jharvey/StingrayIII/cad/stingray3-top.jpg

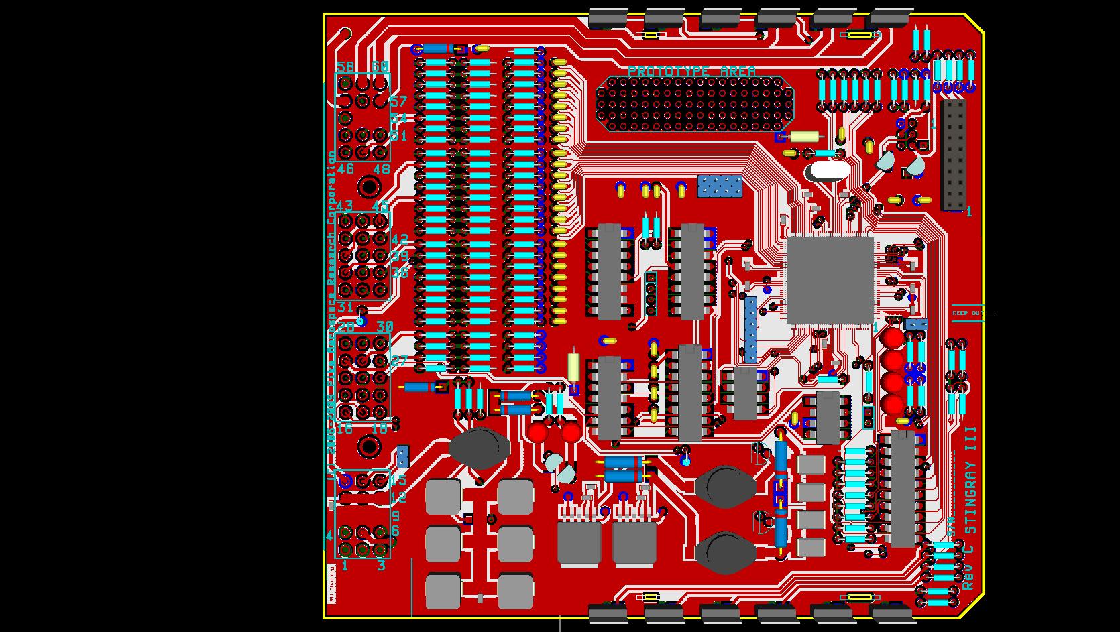
cad/stingray3-top.jpg
