jharvey/StingrayIII/cad/stingray3-3d.jpg

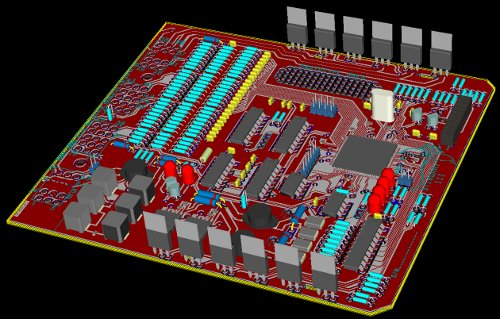
cad/stingray3-3d.jpg
