jharvey/StingrayIII/cad/PCB_trace-via_specs.xls

Key notes from the below (summary)
A min trace width of 10 mills, is good for 8/8 PCB houses and can handle .444 internal amps and .886 external amps
For 1 amp you and 1 oz copper, use a trace width wider than 11.8 mil external, and 30.8 mills internal. Min via drill of 20 mil.
For 5 amp you and 1 oz copper, use a trace width wider than 109 mil external, and 283 mills internal. Min via drill of 45 mil.
For 10 amp you and 1 oz copper, use a trace width wider than 283 mil external, and 737 mills internal. Min via drill of 123 mil.
Per online calculator found here http://circuitcalculator.com/wordpress/2006/01/31/pcb-trace-width-calculator
min via's from http://batchpcb.com/index.php/Faq via calcs from http://circuitcalculator.com/wordpress/2006/03/12/pcb-via-calculator/
9 mill wide trace (KICAD help file class 4 IPC class?) |  |  |  | 13 mil min drill diameter
current .8201 A |  | current .4101 A |  | 15 | mil finished hole dia
1 oz/ft^2 |  | 1 oz/ft^2 |  | 1 | mil plating thickness
temp rise 10 c |  | temp rise 10 c |  | 60 | mil via length
ambient 25 c |  | ambient 25 c
1 inch long |  | 1 inch long |  | 4 | amps applied
 |  |  |  | 1.9e-06 | Ohm-cm plating resistivity
--- for and external trace--- |  | --- for an internal trace---
internal trace |  | internal trace |  | 0.000893 | Ohms
23.4 | mill | 9 | mill | 0.0357 | Volts dropped
0.0216 | ohm | 0.0561 | ohm | 0.0143 | Watts dissipated
0.0177 | V drop | 0.0230 | V drop | 2.26 | Amps estimated ampacity
0.0145 | Watts | 0.0094 | Watts
external trace |  | external trace
9 | mill | 3.46 | mill
0.0561 | ohm | 0.146 | ohm
0.0460 | V drop | 0.060 | V drop
0.0377 | Watts | 0.025 | Watts
10 mill wide trace (min recommended for an 8/8 PCB house) |  |  |  | 20 mil min drill diameter
current .886 A |  | current .444 A |  | 22 | mil finished hole dia
1 oz/ft^2 |  | 1 oz/ft^2 |  | 1 | mil plating thickness
temp rise 10 c |  | temp rise 10 c |  | 60 | mil via length
ambient 25 c |  | ambient 25 c
1 inch long |  | 1 inch long |  | 2.94 | amps applied
 |  |  |  | 1.9e-06 | Ohm-cm plating resistivity
--- for and external trace--- |  | --- for an internal trace---
internal trace |  | internal trace |  | 0.000621 | Ohms
26 | mill | 10 | mill | 0.00183 | Volts dropped
0.0194 | ohm | 0.0503 | ohm | 0.00537 | Watts dissipated
0.0172 | V drop | 0.0223 | V drop | 2.94 | Amps estimated ampacity
0.0152 | Watts | 0.0099 | Watts
external trace |  | external trace
10 | mill | 3.86 | mill
0.0504 | ohm | 0.131 | ohm
0.0447 | V drop | 0.058 | V drop
0.0396 | Watts | 0.026 | Watts
Trace width |  |  | via calcs
current 1 A |  |  | 15 | mil finished hole dia
1 oz/ft^2 |  |  | 1 | mil plating thickness
temp rise 10 c |  |  | 60 | mil via length
ambient 25 c |  |  | 13 | drill dia
1 inch long |  |  | 1 | amps applied
 |  |  | 1.9e-06 | Ohm-cm plating resistivity
internal trace
30.8 | mill |  | 0.000893 | Ohms
0.0164 | ohm |  | 0.0357 | Volts dropped
0.0164 | V drop |  | 0.0143 | Watts dissipated
0.0164 | Watts |  | 2.26 | Amps estimated ampacity
external trace
11.8 | mill
0.0427 | ohm
0.0427 | V drop
0.0427 | Watts
Trace width |  |  | via calcs
current 5 A |  |  | 47 | mil finished hole dia
1 oz/ft^2 |  |  | 1 | mil plating thickness
temp rise 10 c |  |  | 60 | mil via length
ambient 25 c |  |  | 45 | drill dia
1 inch long |  |  | 1 | amps applied
 |  |  | 1.9e-06 | Ohm-cm plating resistivity
internal trace
283 | mill |  | 0.000298 | Ohms
0.0018 | ohm |  | 0.00149 | Volts dropped
0.0089 | V drop |  | 0.00744 | Watts dissipated
0.0445 | Watts |  | 5.02 | Amps estimated ampacity
external trace
109 | mill
0.0046 | ohm
0.0232 | V drop
0.1160 | Watts
Trace width |  |  | via calcs
current 10 A |  |  | 125 | mil finished hole dia
1 oz/ft^2 |  |  | 1 | mil plating thickness
temp rise 10 c |  |  | 60 | mil via length
ambient 25 c |  |  | 123 | drill dia
1 inch long |  |  | 10 | amps applied
 |  |  | 1.9e-06 | Ohm-cm plating resistivity
internal trace
737 | mill |  | 0.000113 | Ohms
0.0007 | ohm |  | 0.00113 | Volts dropped
0.0069 | V drop |  | 0.0113 | Watts dissipated
0.0685 | Watts |  | 10.1 | Amps estimated ampacity
external trace
283 | mill
0.0018 | ohm
0.0178 | V drop
0.1780 | Watts
