jharvey/StingrayIII/cad/scripts/stingray-417x500.jpg

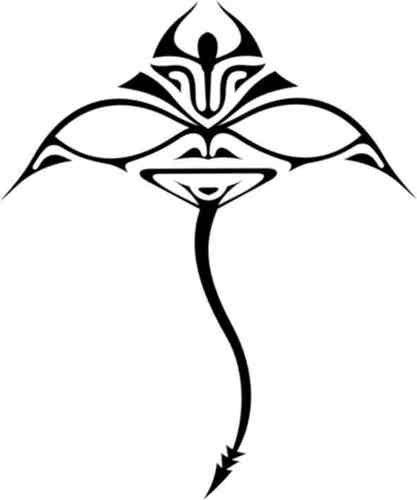
cad/scripts/stingray-417x500.jpg
