jharvey/StingrayIII/cad/stingray3.xlsx

REFERENCE | VALUE | FOOTPRINT | ADDITIONAL | MANUFACTURER | MANUFACTURER PART# | DIGIKEY PART# | DIGIKEY $ | NEWARKINONE PART # | NEWARKINONE $ | BEST PRICE
C101 | 100 nf | SM0805 | CAP CER .1UF 100V X7R 0805 | Murata Electronics | GCM21BR72A104KA37L | 490-4789-1-ND | 0.17
C102 | 100 nF | SM0805 | CAP CER .1UF 100V X7R 0805 | Murata Electronics | GCM21BR72A104KA37L | 490-4789-1-ND | 0.17
C103 | 100 nF | SM0805 | CAP CER .1UF 100V X7R 0805 | Murata Electronics | GCM21BR72A104KA37L | 490-4789-1-ND | 0.17
C104 | 100 nF | SM0805 | CAP CER .1UF 100V X7R 0805 | Murata Electronics | GCM21BR72A104KA37L | 490-4789-1-ND | 0.17
C105 | 100 nF | SM0805 | CAP CER .1UF 100V X7R 0805 | Murata Electronics | GCM21BR72A104KA37L | 490-4789-1-ND | 0.17
C106 | 100 nF | SM0805 | CAP CER .1UF 100V X7R 0805 | Murata Electronics | GCM21BR72A104KA37L | 490-4789-1-ND | 0.17
C107 | 100 nF | SM0805 | CAP CER .1UF 100V X7R 0805 | Murata Electronics | GCM21BR72A104KA37L | 490-4789-1-ND | 0.17
C108 | 100 nF | SM0805 | CAP CER .1UF 100V X7R 0805 | Murata Electronics | GCM21BR72A104KA37L | 490-4789-1-ND | 0.17
C109 | 100 nF | SM0805 | CAP CER .1UF 100V X7R 0805 | Murata Electronics | GCM21BR72A104KA37L | 490-4789-1-ND | 0.17
C110 | 22 pF | C1 | CAP 22PF 50V CERAMIC C0G 5% | Vishay | K220J15C0GF5TL2 | BC1005CT-ND | 0.076
C111 | 22 pF | C1 | CAP 22PF 50V CERAMIC C0G 5% | Vishay | K220J15C0GF5TL2 | BC1005CT-ND | 0.076
C112 | 100 nF | C1 | CAP .10UF 50V CERAMIC X7R 10% | Vishay | K104K15X7RF5TL2 | BC1084CT-ND | 0.081
C116 | 100 nF | C1 | CAP .10UF 50V CERAMIC X7R 10% | Vishay | K104K15X7RF5TL2 | BC1084CT-ND | 0.081
C123 | 100 nF | C1 | CAP .10UF 50V CERAMIC X7R 10% | Vishay | K104K15X7RF5TL2 | BC1084CT-ND | 0.081
C124 | 100 nF | C1 | CAP .10UF 50V CERAMIC X7R 10% | Vishay | K104K15X7RF5TL2 | BC1084CT-ND | 0.081
C125 | 100 nF | SM0805 | CAP CER .1UF 100V X7R 0805 | Murata Electronics | GCM21BR72A104KA37L | 490-4789-1-ND | 0.17
C160 | 2.2nF | C1 | CAP 2.2NF 50VDC X7R 10% RDL 2.54 | Kemet | C320C222K5R5CA | C320C222K5R5CA-ND | 0.08
C330 | 100 nF | C1 | CAP .10UF 50V CERAMIC X7R 10% | Vishay | K104K15X7RF5TL2 | BC1084CT-ND | 0.081
C331 | 100 nF | C1 | CAP .10UF 50V CERAMIC X7R 10% | Vishay | K104K15X7RF5TL2 | BC1084CT-ND | 0.081
C332 | 100 nF | C1 | CAP .10UF 50V CERAMIC X7R 10% | Vishay | K104K15X7RF5TL2 | BC1084CT-ND | 0.081
C333 | 100 nF | C1 | CAP .10UF 50V CERAMIC X7R 10% | Vishay | K104K15X7RF5TL2 | BC1084CT-ND | 0.081
C334 | 100 nF | C1 | CAP .10UF 50V CERAMIC X7R 10% | Vishay | K104K15X7RF5TL2 | BC1084CT-ND | 0.081
C335 | 100 nF | C1 | CAP .10UF 50V CERAMIC X7R 10% | Vishay | K104K15X7RF5TL2 | BC1084CT-ND | 0.081
C336 | 100 nF | C1 | CAP .10UF 50V CERAMIC X7R 10% | Vishay | K104K15X7RF5TL2 | BC1084CT-ND | 0.081
C337 | 100 nF | C1 | CAP .10UF 50V CERAMIC X7R 10% | Vishay | K104K15X7RF5TL2 | BC1084CT-ND | 0.081
C340 | 100 nF | C1 | CAP .10UF 50V CERAMIC X7R 10% | Vishay | K104K15X7RF5TL2 | BC1084CT-ND | 0.081
C341 | 100 nF | C1 | CAP .10UF 50V CERAMIC X7R 10% | Vishay | K104K15X7RF5TL2 | BC1084CT-ND | 0.081
C342 | 100 nF | C1 | CAP .10UF 50V CERAMIC X7R 10% | Vishay | K104K15X7RF5TL2 | BC1084CT-ND | 0.081
C343 | 100 nF | C1 | CAP .10UF 50V CERAMIC X7R 10% | Vishay | K104K15X7RF5TL2 | BC1084CT-ND | 0.081
C344 | 100 nF | C1 | CAP .10UF 50V CERAMIC X7R 10% | Vishay | K104K15X7RF5TL2 | BC1084CT-ND | 0.081
C345 | 100 nF | C1 | CAP .10UF 50V CERAMIC X7R 10% | Vishay | K104K15X7RF5TL2 | BC1084CT-ND | 0.081
C346 | 100 nF | C1 | CAP .10UF 50V CERAMIC X7R 10% | Vishay | K104K15X7RF5TL2 | BC1084CT-ND | 0.081
C347 | 100 nF | C1 | CAP .10UF 50V CERAMIC X7R 10% | Vishay | K104K15X7RF5TL2 | BC1084CT-ND | 0.081
C401 | 0.01uF | SM0805 | CAP CER 0.01UF 50V X7R RAD | Cornell Dubilier Electronics | M15R103K5-F | M15R103K5-F-ND | 0.1376
C402 | 100 nF | SM0805 | CAP CER .1UF 100V X7R 0805 | Murata Electronics | GCM21BR72A104KA37L | 490-4789-1-ND | 0.17
C403 | 47uF | SMD-CPOL-JA0
C404 | 47uF | SMD-CPOL-JA0
C405 | 47uF | SMD-CPOL-JA0
C406 | 100uF | SM2112L
C407 | 100uF | SM2112L
C411 | 0.01uF | SM0805 | CAP CER .1UF 100V X7R 0805 | Murata Electronics | GCM21BR72A104KA37L | 490-4789-1-ND | 0.17
C412 | 100 nF | SM0805 | CAP CER .1UF 100V X7R 0805 | Murata Electronics | GCM21BR72A104KA37L | 490-4789-1-ND | 0.17
C413 | 47uF | SMD-CPOL-JA0
C414 | 47uF | SMD-CPOL-JA0
C415 | 47uF | SMD-CPOL-JA0
C416 | 100uF | SM2112L
C417 | 100uF | SM2112L
C431 | 100 nF | C1 | CAP .10UF 50V CERAMIC X7R 10% | Vishay | K104K15X7RF5TL2 | BC1084CT-ND | 0.081
C441 | 100 nF | SM0805 | CAP CER .1UF 100V X7R 0805 | Murata Electronics | GCM21BR72A104KA37L | 490-4789-1-ND | 0.17
C442 | 100 nF | SM0805 | CAP CER .1UF 100V X7R 0805 | Murata Electronics | GCM21BR72A104KA37L | 490-4789-1-ND | 0.17
C701 | 100 nF | C1 | CAP .10UF 50V CERAMIC X7R 10% | Vishay | K104K15X7RF5TL2 | BC1084CT-ND | 0.081
C721 | 100 nF | C1 | CAP .10UF 50V CERAMIC X7R 10% | Vishay | K104K15X7RF5TL2 | BC1084CT-ND | 0.081
C722 | 100 nF | C1 | CAP .10UF 50V CERAMIC X7R 10% | Vishay | K104K15X7RF5TL2 | BC1084CT-ND | 0.081
C723 | 100 nF | C1 | CAP .10UF 50V CERAMIC X7R 10% | Vishay | K104K15X7RF5TL2 | BC1084CT-ND | 0.081
C724 | 100 nF | C1 | CAP .10UF 50V CERAMIC X7R 10% | Vishay | K104K15X7RF5TL2 | BC1084CT-ND | 0.081
C807 | 100 nF | C1 | CAP .10UF 50V CERAMIC X7R 10% | Vishay | K104K15X7RF5TL2 | BC1084CT-ND | 0.081
C1401 | 0.1uF | C1 | CAP .10UF 50V CERAMIC X7R 10% | Vishay | K104K15X7RF5TL2 | BC1084CT-ND | 0.081
C1402 | 0.1uF | C1 | CAP .10UF 50V CERAMIC X7R 10% | Vishay | K104K15X7RF5TL2 | BC1084CT-ND | 0.081
C1403 | 0.1uF | C1 | CAP .10UF 50V CERAMIC X7R 10% | Vishay | K104K15X7RF5TL2 | BC1084CT-ND | 0.081
C1404 | 0.1uF | C1 | CAP .10UF 50V CERAMIC X7R 10% | Vishay | K104K15X7RF5TL2 | BC1084CT-ND | 0.081
C1405 | 0.1uF | C1 | CAP .10UF 50V CERAMIC X7R 10% | Vishay | K104K15X7RF5TL2 | BC1084CT-ND | 0.081
C1406 | 0.1uF | C1 | CAP .10UF 50V CERAMIC X7R 10% | Vishay | K104K15X7RF5TL2 | BC1084CT-ND | 0.081
C1407 | 0.1uF | C1 | CAP .10UF 50V CERAMIC X7R 10% | Vishay | K104K15X7RF5TL2 | BC1084CT-ND | 0.081
C1408 | 0.1uF | C1 | CAP .10UF 50V CERAMIC X7R 10% | Vishay | K104K15X7RF5TL2 | BC1084CT-ND | 0.081
C1411 | 100 nF | C1 | CAP .10UF 50V CERAMIC X7R 10% | Vishay | K104K15X7RF5TL2 | BC1084CT-ND | 0.081
C1413 | 100 nF | C1 | CAP .10UF 50V CERAMIC X7R 10% | Vishay | K104K15X7RF5TL2 | BC1084CT-ND | 0.081
C1415 | 4.7uF | CP4
C1416 | 4.7uF | CP4
C1417 | 100 nF | C1 | CAP .10UF 50V CERAMIC X7R 10% | Vishay | K104K15X7RF5TL2 | BC1084CT-ND | 0.081
D104 | ST1 | LEDV | LED 5MM HI-EFF RED TRANS | Lite-On Inc. | LTL-307EE | 160-1701-ND | 0.09
D105 | ST2 | LEDV | LED 5MM HI-EFF RED TRANS | Lite-On Inc. | LTL-307EE | 160-1701-ND | 0.09
D106 | ST3 | LEDV | LED 5MM HI-EFF RED TRANS | Lite-On Inc. | LTL-307EE | 160-1701-ND | 0.09
D107 | ST4 | LEDV | LED 5MM HI-EFF RED TRANS | Lite-On Inc. | LTL-307EE | 160-1701-ND | 0.09
D156 | 1N4148 | D4 | DIODE SGL JUNC 100V 4.0NS DO-35 | Fairchild Semiconductor | 1N4148 | 1N4148FS-ND | 0.04
D157 | 1N4148 | D4 | DIODE SGL JUNC 100V 4.0NS DO-35 | Fairchild Semiconductor | 1N4148 | 1N4148FS-ND | 0.04
D166 | LED | LEDV | LED 5MM HI-EFF RED TRANS | Lite-On Inc. | LTL-307EE | 160-1701-ND | 0.09
D167 | LED | LEDV | LED 5MM HI-EFF RED TRANS | Lite-On Inc. | LTL-307EE | 160-1701-ND | 0.09
D401 | SB350 | D5 | DIODE SCHOTTKY 3A 50V DO-41 | Fairchild Semiconductor | SB350 | SB350-ND | 0.126
D402 | 1N5400 | D5 | RECTIFIER GPP 50V 3A DO-201AD | Diodes Inc. | 1N5400-T | 1N5400DICT-ND | 0.46
D411 | SB350 | D5 | DIODE SCHOTTKY 3A 50V DO-41 | Fairchild Semiconductor | SB350 | SB350-ND | 0.126
D412 | 1N5400 | D5 | RECTIFIER GPP 50V 3A DO-201AD | Diodes Inc. | 1N5400-T | 1N5400DICT-ND | 0.46
D431 | 4.7V | D4 | DIODE ZENER 1W 4.7V DO41 | Micro Commercial Co. | 1N4732A-TP | 1N4732A-TPCT-ND | 0.44
D826 | 1N4001 | D4 | DIODE GEN PURPOSE 50V 1A DO41 | Fairchild Semiconductor | 1N4001 | 1N4001FSCT-ND | 0.09
F101 | 4MHz | AWCR | RESONATOR 4.00MHZ CERAMIC INDUST | Murata Electronics | CSTLS4M00G53Z-B0 | 490-1221-ND | 0.29
J1 | 581-01-60-005 | 581-01-60-005 | ModICE I/O Connectors 60 Pos Black | CINCH | 581-01-60-005 | ----- |  | 78K5084 | 34.43
J101 | JTAG | pin_array_10x2
J431 | 12V24 | SIL-3
J701 | TERM | SIL-2
K2 | M0 | SIL-3
K4 | M1 | SIL-3
L401 | 22uH | PM5002 | INDUCTOR POWER 22UH 3.6A SMD | JW Miller | PM5022-220M-RC | M8599CT-ND | 1.35
L411 | 22uH | PM5002 | INDUCTOR POWER 22UH 3.6A SMD | JW Miller | PM5022-220M-RC | M8599CT-ND | 1.35
L441 | 22uH | PM5002 | INDUCTOR POWER 22UH 3.6A SMD | JW Miller | PM5022-220M-RC | M8599CT-ND | 1.35
P2 | AUX1 | SIL-4
P109 | CONN_1 | TEST_POINT
P110 | CONN_1 | TEST_POINT
P117 | R-T | SIL-3
P121 | CONN_1 | TEST_POINT
P122 | CONN_1 | TEST_POINT
P123 | CONN_1 | TEST_POINT
P124 | CONN_1 | TEST_POINT
P125 | CONN_1 | TEST_POINT
P126 | CONN_1 | TEST_POINT
P127 | CONN_1 | TEST_POINT
P128 | CONN_1 | TEST_POINT
P129 | CONN_1 | TEST_POINT
P130 | CONN_1 | TEST_POINT
P131 | CONN_1 | TEST_POINT
P132 | CONN_1 | TEST_POINT
P133 | CONN_1 | TEST_POINT
P134 | CONN_1 | TEST_POINT
P135 | CONN_1 | TEST_POINT
P136 | CONN_1 | TEST_POINT
Q101 | MPSA06 | TO92-INVERT | TRANSISTOR AMP NPN GP TO-92 | ON Semiconductor | MPSA06RLRAG | MPSA06RLRAGOSCT-ND | 0.42 | 45J1643 | 0.078
Q102 | MPSA06 | TO92-INVERT | TRANSISTOR AMP NPN GP TO-92 | ON Semiconductor | MPSA06RLRAG | MPSA06RLRAGOSCT-ND | 0.42 | 45J1643 | 0.078
Q103 | MPSA06 | TO92-INVERT | TRANSISTOR AMP NPN GP TO-92 | ON Semiconductor | MPSA06RLRAG | MPSA06RLRAGOSCT-ND | 0.42 | 45J1643 | 0.078
Q501 | IRGB14C40LPBF | TO220V_GCE | IGBT IGNITION 430V 20A TO220AB | International Rectifier | IRGB14C40LPBF | IRGB14C40LPBF-ND | 3.63 | 63J7438 | 3.56
Q502 | IRGB14C40LPBF | TO220V_GCE | IGBT IGNITION 430V 20A TO220AB | International Rectifier | IRGB14C40LPBF | IRGB14C40LPBF-ND | 3.63 | 63J7438 | 3.56
Q503 | IRGB14C40LPBF | TO220V_GCE | IGBT IGNITION 430V 20A TO220AB | International Rectifier | IRGB14C40LPBF | IRGB14C40LPBF-ND | 3.63 | 63J7438 | 3.56
Q504 | IRGB14C40LPBF | TO220V_GCE | IGBT IGNITION 430V 20A TO220AB | International Rectifier | IRGB14C40LPBF | IRGB14C40LPBF-ND | 3.63 | 63J7438 | 3.56
Q505 | IRGB14C40LPBF | TO220V_GCE | IGBT IGNITION 430V 20A TO220AB | International Rectifier | IRGB14C40LPBF | IRGB14C40LPBF-ND | 3.63 | 63J7438 | 3.56
Q506 | IRGB14C40LPBF | TO220V_GCE | IGBT IGNITION 430V 20A TO220AB | International Rectifier | IRGB14C40LPBF | IRGB14C40LPBF-ND | 3.63 | 63J7438 | 3.56
Q507 | IRGB14C40LPBF | TO220V_GCE | IGBT IGNITION 430V 20A TO220AB | International Rectifier | IRGB14C40LPBF | IRGB14C40LPBF-ND | 3.63 | 63J7438 | 3.56
Q508 | IRGB14C40LPBF | TO220V_GCE | IGBT IGNITION 430V 20A TO220AB | International Rectifier | IRGB14C40LPBF | IRGB14C40LPBF-ND | 3.63 | 63J7438 | 3.56
Q509 | IRGB14C40LPBF | TO220V_GCE | IGBT IGNITION 430V 20A TO220AB | International Rectifier | IRGB14C40LPBF | IRGB14C40LPBF-ND | 3.63 | 63J7438 | 3.56
Q510 | IRGB14C40LPBF | TO220V_GCE | IGBT IGNITION 430V 20A TO220AB | International Rectifier | IRGB14C40LPBF | IRGB14C40LPBF-ND | 3.63 | 63J7438 | 3.56
Q511 | IRGB14C40LPBF | TO220V_GCE | IGBT IGNITION 430V 20A TO220AB | International Rectifier | IRGB14C40LPBF | IRGB14C40LPBF-ND | 3.63 | 63J7438 | 3.56
Q512 | IRGB14C40LPBF | TO220V_GCE | IGBT IGNITION 430V 20A TO220AB | International Rectifier | IRGB14C40LPBF | IRGB14C40LPBF-ND | 3.63 | 63J7438 | 3.56
R101 | 1M | R3 | RES 1.0M OHM 1/4W 5% CARBON FILM | Yageo | CFR-25JB-1M0 | 1.0MQBK-ND | 0.064
R103 | 2K2 | R3 | RES 2.2K OHM 1/4W 5% CARBON FILM | Yageo | CFR-25JB-2K2 | 2.2KQBK-ND | 0.064
R107 | 1K5 | R3 | RES 1.5K OHM 1/4W 5% CARBON FILM | Yageo | CFR-25JB-1K5 | 1.5KQBK-ND | 0.064
R108 | 1K5 | R3 | RES 1.5K OHM 1/4W 5% CARBON FILM | Yageo | CFR-25JB-1K5 | 1.5KQBK-ND | 0.064
R109 | 1K5 | R3 | RES 1.5K OHM 1/4W 5% CARBON FILM | Yageo | CFR-25JB-1K5 | 1.5KQBK-ND | 0.064
R110 | 1K5 | R3 | RES 1.5K OHM 1/4W 5% CARBON FILM | Yageo | CFR-25JB-1K5 | 1.5KQBK-ND | 0.064
R116 | 2K | R3 | RES 2.0K OHM 1/4W 5% CARBON FILM | Yageo | CFR-25JB-2K0 | 2.0KQBK-ND | 0.064
R117 | 2K | R3 | RES 2.0K OHM 1/4W 5% CARBON FILM | Yageo | CFR-25JB-2K0 | 2.0KQBK-ND | 0.064
R122 | 1M3 | SM0805 | RES 1.30M OHM 1/8W 1% 0805 SMD | Yageo | RC0805FR-071M3L | 311-1.30MCRCT-ND | 0.74
R126 | 10K | R3 | RES 10K OHM 1/4W 5% CARBON FILM | Yageo | CFR-25JB-10K | 10KQBK-ND | 0.064
R127 | NC | R3
R128 | 10K | R3 | RES 10K OHM 1/4W 5% CARBON FILM | Yageo | CFR-25JB-10K | 10KQBK-ND | 0.064
R156 | 10K | R3 | RES 10K OHM 1/4W 5% CARBON FILM | Yageo | CFR-25JB-10K | 10KQBK-ND | 0.064
R157 | 10K | R3 | RES 10K OHM 1/4W 5% CARBON FILM | Yageo | CFR-25JB-10K | 10KQBK-ND | 0.064
R160 | 47K | R3 | RES 47K OHM 1/4W 5% CARBON FILM | Yageo | CFR-25JB-47K | 47KQBK-ND | 0.06
R161 | 10K | R3 | RES 10K OHM 1/4W 5% CARBON FILM | Yageo | CFR-25JB-10K | 10KQBK-ND | 0.064
R211 | 1K | R3 | RES 1.0K OHM 1/4W 5% CARBON FILM | Yageo | CFR-25JB-1K0 | 1.0KQBK-ND | 0.06
R212 | 1K | R3 | RES 1.0K OHM 1/4W 5% CARBON FILM | Yageo | CFR-25JB-1K0 | 1.0KQBK-ND | 0.06
R213 | 1K | R3 | RES 1.0K OHM 1/4W 5% CARBON FILM | Yageo | CFR-25JB-1K0 | 1.0KQBK-ND | 0.06
R214 | 1K | R3 | RES 1.0K OHM 1/4W 5% CARBON FILM | Yageo | CFR-25JB-1K0 | 1.0KQBK-ND | 0.06
R222 | 10K | R3 | RES 10K OHM 1/4W 5% CARBON FILM | Yageo | CFR-25JB-10K | 10KQBK-ND | 0.064
R223 | 10K | R3 | RES 10K OHM 1/4W 5% CARBON FILM | Yageo | CFR-25JB-10K | 10KQBK-ND | 0.064
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
R1446 | 4K7 | R3 | RES 4.7K OHM 1/4W 5% CARBON FILM | Yageo | CFR-25JB-4K7 | 4.7KQBK-ND | 0.064
R1447 | 4K7 | R3 | RES 4.7K OHM 1/4W 5% CARBON FILM | Yageo | CFR-25JB-4K7 | 4.7KQBK-ND | 0.064
R1448 | 10K | R3 | RES 10K OHM 1/4W 5% CARBON FILM | Yageo | CFR-25JB-10K | 10KQBK-ND | 0.064
U101 | STR730FZ2T7 | TQFP144 | IC MCU ARM7 256K FLASH 144-TQFP | ST Microelectronics | STR730FZ2T7 | 497-5140-1-ND | 28.62 | 24M7942 | 26.21
U102 | NCV33064P | TO92 | IC SENSOR UNDERVOLTAGE TO92 | ON Semiconductor | NCV33064P-5RAG | NCV33064P-5RAGOSCT-ND | 2.7
U103 | MCP6S28 | 16DIP-ELL300 | IC PGA 8CH R-R I/O 16DIP | Microchip Technology | MCP6S28-I/P | MCP6S28-I/P-ND | 2.66 | 58M8930 | 3.95
U104 | MCP3208 | 16DIP-ELL300 | IC ADC 12BIT 2.7V 8CH SPI 16-DIP | Microchip Technology | MCP3208-CI/P | MCP3208-CI/P-ND | 4.18 | 58K1815 | 3.48
U302 | 74HC14 | 14DIP-ELL300 | IC HEX INV SCHMITT TRIG 14-DIP | Texas Instruments | CD74HC14E | 296-12786-5-ND | 0.64 | 67K0138 | 0.576
U401 | LM2676-5.0 | TO263 | IC REG SIMPLE SWITCHER TO-263-7 | National Semiconductor | LM2676S-5.0/NOPB | LM2676S-5.0-ND | 4.48 | 41K4153 | 4.26
U402 | NCV33064P | TO92 | IC SENSOR UNDERVOLTAGE TO92 | ON Semiconductor | NCV33064P-5RAG | NCV33064P-5RAGOSCT-ND | 2.7
U411 | LM2676-5.0 | TO263 | IC REG SIMPLE SWITCHER TO-263-7 | National Semiconductor | LM2676S-5.0/NOPB | LM2676S-5.0-ND | 4.48 | 41K4153 | 4.26
U412 | NCV33064P | TO92 | IC SENSOR UNDERVOLTAGE TO92 | ON Semiconductor | NCV33064P-5RAG | NCV33064P-5RAGOSCT-ND | 2.7
U720 | MCP2551 | 8DIP-ELL300 | IC TRANSCEIVER CAN HI-SPD 8-DIP | Microchip Technology | MCP2551-I/P | MCP2551-I/P-ND | 1.32 | 69K7603 | 1.26
U721 | MAX232 | 16DIP-ELL300 | IC DUAL EIA-232 DRVR/RCVR 16-DIP | Texas Instruments | MAX232IN | 296-6940-5-ND | 0.9 | 37K0568 | 0.399
U722 | 25LC1024 | 8DIP-ELL300 | IC SERIAL EEPROM 1M 2.5V 8DIP | Microchip Technology | 25LC1024-I/P | 25LC1024-I/P-ND | 4.4 | 89H3176 | 3.14
U723 | 74HCT244 | 20DIP-ELL300 | IC BUS BUFFER TRI-ST OCTAL 20DIP | ST Microelectronics | M74HCT244B1R | 497-1903-5-ND | 0.67 | 89K0834 | 0.657
VR401 | 10K @ 25C | R1 | THERMISTOR NTC 10K OHM 5% TOLER | GE Sensing | C100F103J | 235-1002-ND | 5.2 | 52F3331 | 6.04
VR402 | 10K @ 25C | R1 | THERMISTOR NTC 10K OHM 5% TOLER | GE Sensing | C100F103J | 235-1002-ND | 5.2 | 52F3331 | 6.04
TOTALS |  |  |  |  |  |  | 132.4476 |  | 137.656
