jharvey/StingrayIII/cad/stingray3.cir

* EESchema Netlist Version 1.0 (Spice format) creation date: 12/8/2006-03:14:18


C721  40 39 0.1uF
C722  41 42 0.1uF
C724  43 0 0.1uF
C723  38 44 0.1uF
U721  39 44 40 41 42 43 35 33 29 31 32 30 34 36 0 38 MAX3232
C711  0 38 0.1uF
C701  0 38 0.1uF
R711  49 50 120
R701  51 52 120
U711  47 0 38 45 50 49 SN65HVD232Q
U701  48 0 38 46 52 51 SN65HVD232Q
U421  53 0 38 LM3940
C442  58 0 0.1uF
C441  54 0 0.1uF
L441  54 58 22uH
C432  38 0 0.1uF
C431  0 53 0.1uF
U431  53 55 59 0 0 1 2 38 SN74LVC2T45DCTR
R412  53 59 10K
R402  53 55 10K
R411  38 3 10K
R401  38 4 10K
C413  58 0 47uF
C414  58 0 47uF
C403  58 0 47uF
C404  58 0 47uF
C406  63 0 100uF
C416  60 0 100uF
C422  38 0 33uF
C421  53 0 0.47uF
U402  4 63 0 MC34064P
U412  3 60 0 MC34064P
D402  63 53 1N5400
D412  60 53 1N5400
C417  60 0 100uF
L411  61 60 22uH
D411  0 61 B340LA-13
C411  56 61 0.01uF
C412  58 0 0.1uF
C415  58 0 47uF
U411  61 58 56 0 62 53 59 LM2676
C407  63 0 100uF
L401  64 63 22uH
D401  0 64 B340LA-13
C401  57 64 0.01uF
C402  58 0 0.1uF
C405  58 0 47uF
U401  64 58 57 0 65 53 55 LM2676
R270  76 74 RPDN
R271  77 74 RPDN
R272  78 74 RPDN
R273  75 74 RPDN
R274  79 74 RPDN
R275  80 74 RPDN
R276  81 74 RPDN
R277  82 74 RPDN
R254  38 79 RPUP
R255  38 80 RPUP
R257  38 82 RPUP
R256  38 81 RPUP
C344  74 79 0.1uF
C347  74 82 0.1uF
C346  74 81 0.1uF
C345  74 80 0.1uF
D247  74 82 3.3V
D246  74 81 3.3V
D245  74 80 3.3V
D244  74 79 3.3V
R264  69 79 RIN
R265  68 80 RIN
R267  66 82 RIN
R266  67 81 RIN
D243  83 75 3.3V
D242  74 78 3.3V
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
D501  0 12 33V/5W
D507  0 6 33V/5W
D508  0 5 33V/5W
J1  13 14 12 11 10 9 54 0 0 316 315 314 313 312 311 298 297 296 295 294 293 292 291 290 289 288 287 286 285 283 284 282 281 280 279 278 277 276 275 310 309 308 307 306 305 304 303 302 301 300 299 0 0 54 5 6 7 8 15 16 581-01-60-005

.end
