jharvey/StingrayIII/cad/ad.sch

## KiCad design cad/ad.sch (2011-09-04)

Schematic: ad.sch

Parts:
C1301, C1302: 0.1uF
C1303, C1304: 4.7uF
U1301, U1302: TLV1548-Q1
