jharvey/StingrayIII/cad/amp.sch

## KiCad design cad/amp.sch (2011-09-04)

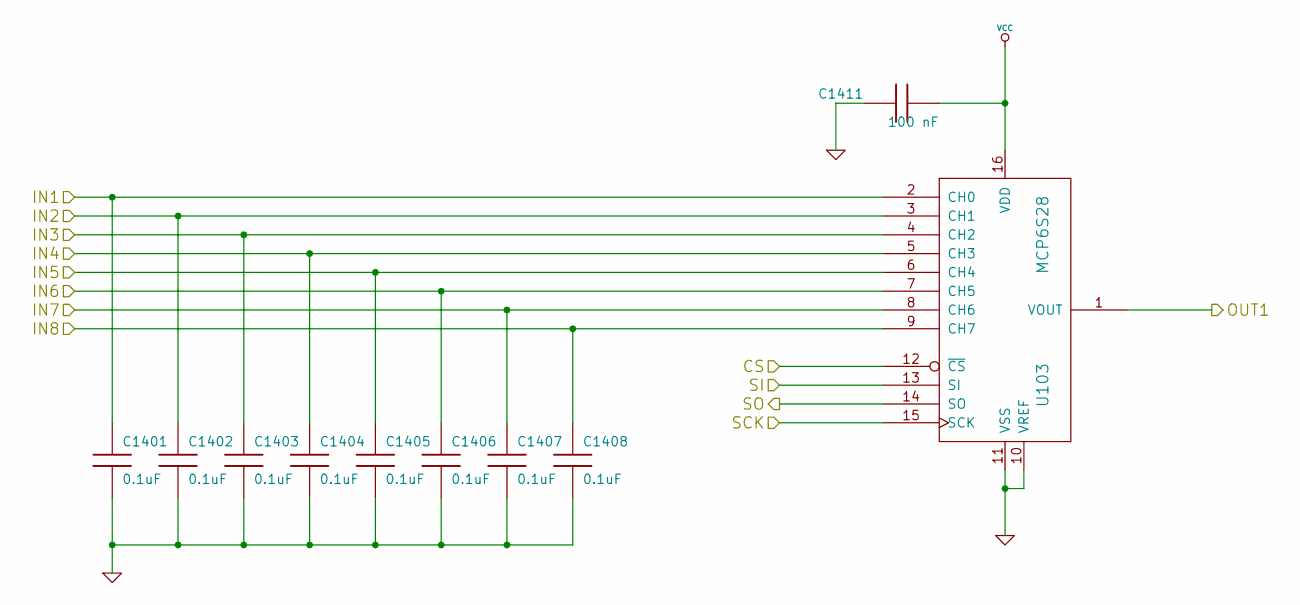
[picture p4: schematic amp.sch]

Parts:
C1401, C1402, C1403, C1404, C1405, C1406, C1407, C1408: 0.1uF
C1411: 100 nF
U103: MCP6S28

Connections:
CS: U103.12 (~CS)
GND: C1401.2, C1402.2, C1403.2, C1404.2, C1405.2, C1406.2, C1407.2, C1408.2, C1411.1, U103.10 (VREF), U103.11 (VSS)
IN1: C1401.1, U103.2 (CH0)
IN2: C1402.1, U103.3 (CH1)
IN3: C1403.1, U103.4 (CH2)
IN4: C1404.1, U103.5 (CH3)
IN5: C1405.1, U103.6 (CH4)
IN6: C1406.1, U103.7 (CH5)
IN7: C1407.1, U103.8 (CH6)
IN8: C1408.1, U103.9 (CH7)
OUT1: U103.1 (VOUT)
SCK: U103.15 (SCK)
SI: U103.13 (SI)
SO: U103.14 (SO)
VCC: C1411.2, U103.16 (VDD)
