jharvey/StingrayIII/cad/analog.sch

## KiCad design cad/analog.sch (2011-09-04)

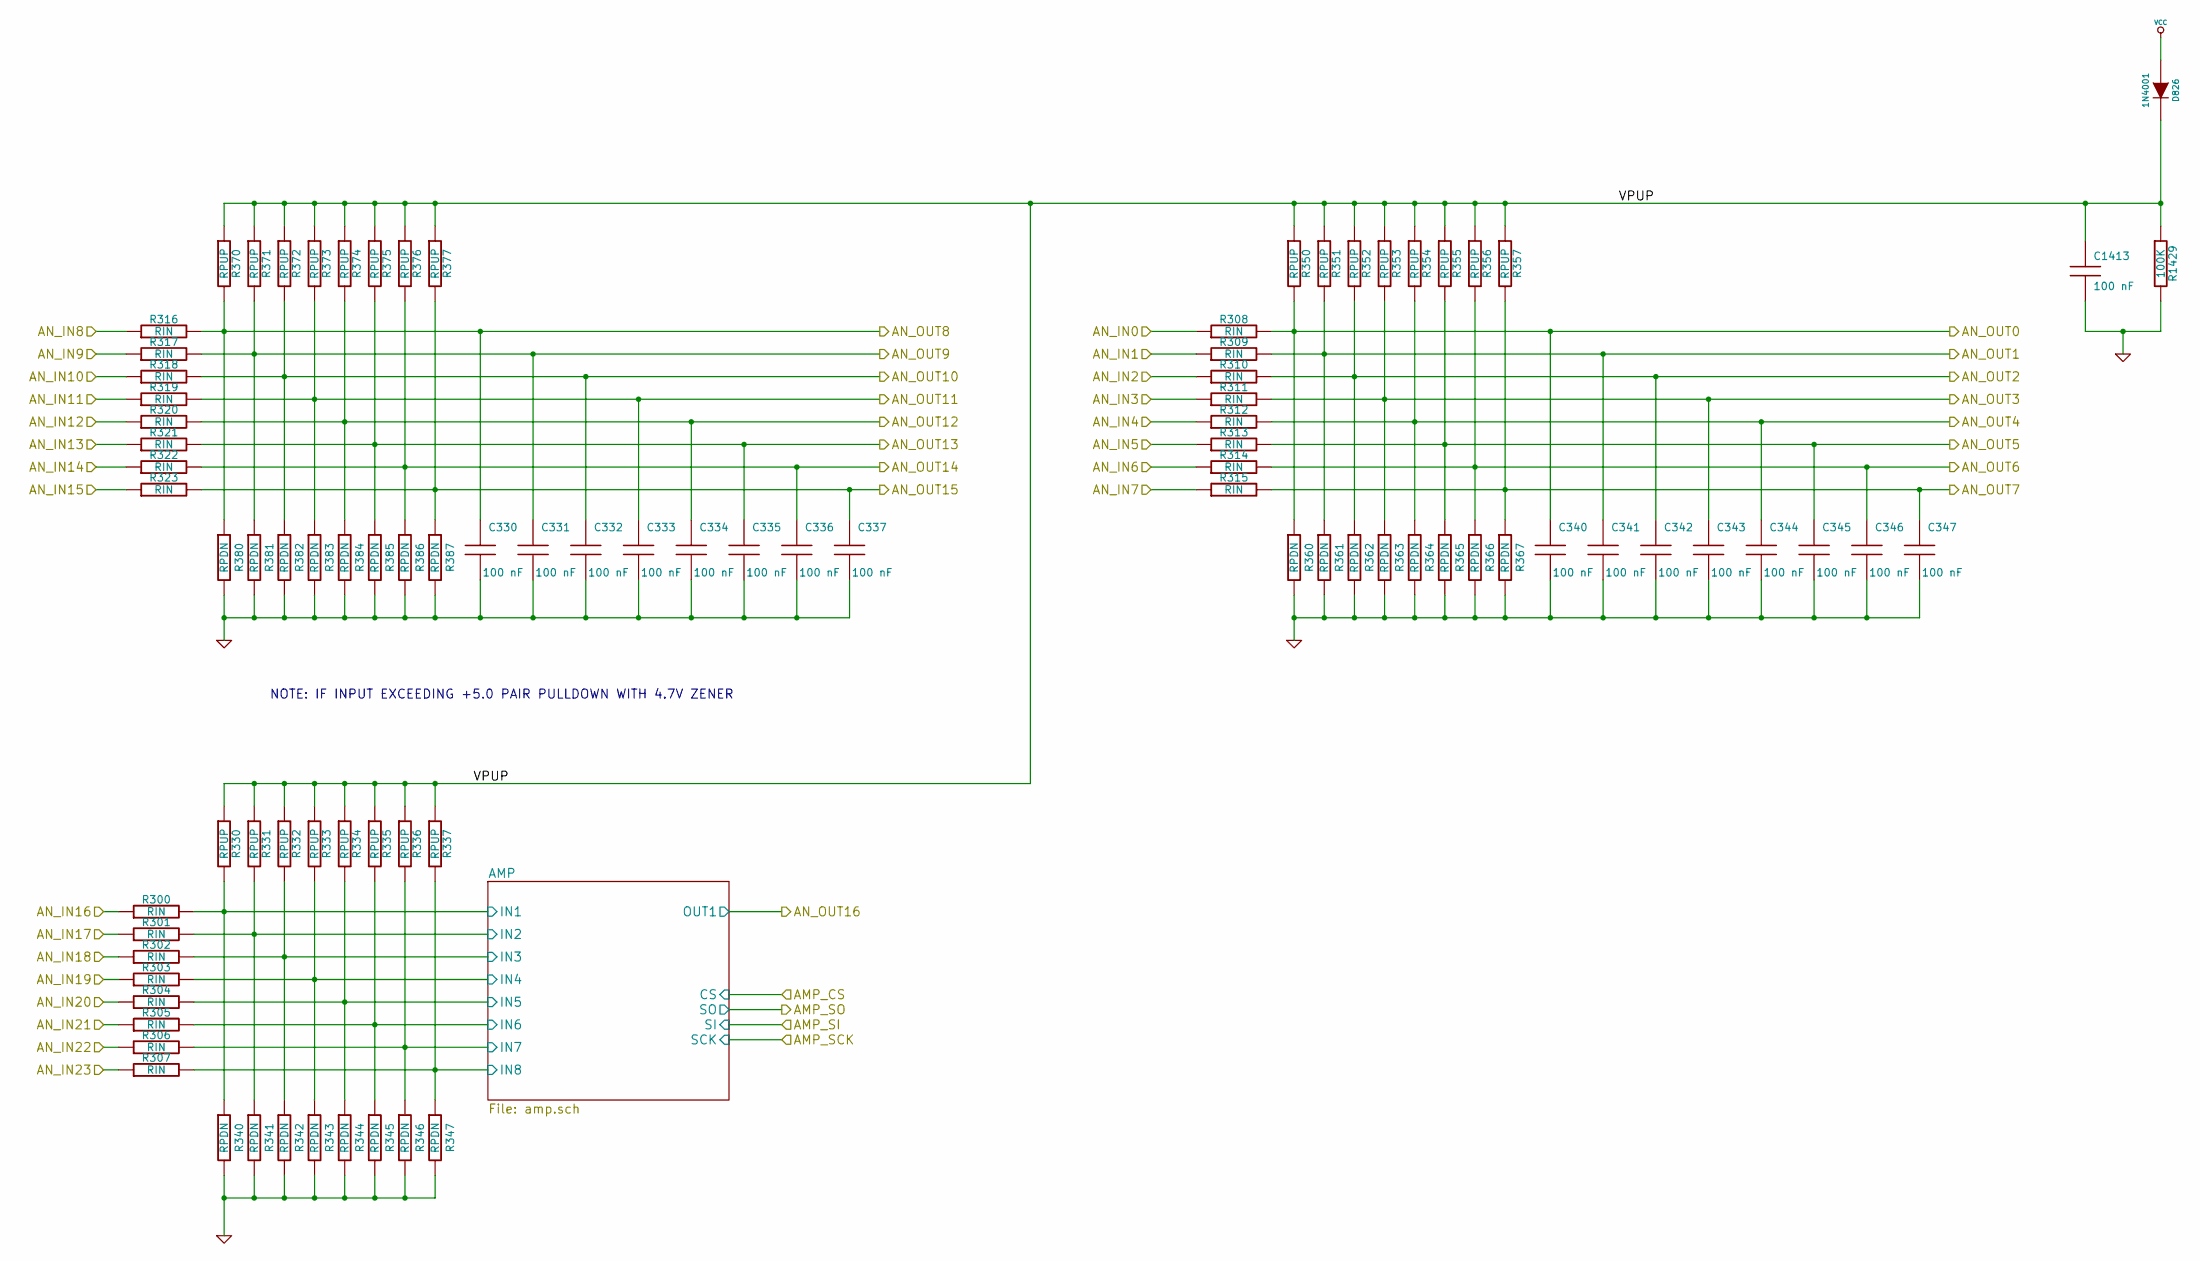
[picture p5: schematic analog.sch]

Parts:
C330, C331, C332, C333, C334, C335, C336, C337, C340, C341, C342, C343, C344, C345, C346, C347, C1413: 100 nF
D826: 1N4001
R300, R301, R302, R303, R304, R305, R306, R307, R308, R309, R310, R311, R312, R313, R314, R315, R316, R317, R318, R319, R320, R321, R322, R323: RIN
R330, R331, R332, R333, R334, R335, R336, R337, R350, R351, R352, R353, R354, R355, R356, R357, R370, R371, R372, R373, R374, R375, R376, R377: RPUP
R340, R341, R342, R343, R344, R345, R346, R347, R360, R361, R362, R363, R364, R365, R366, R367, R380, R381, R382, R383, R384, R385, R386, R387: RPDN
R1429: 100K

Connections:
AN_IN0: R308.1
AN_IN1: R309.1
AN_IN2: R310.1
AN_IN3: R311.1
AN_IN4: R312.1
AN_IN5: R313.1
AN_IN6: R314.1
AN_IN7: R315.1
AN_IN8: R316.1
AN_IN9: R317.1
AN_IN10: R318.1
AN_IN11: R319.1
AN_IN12: R320.1
AN_IN13: R321.1
AN_IN14: R322.1
AN_IN15: R323.1
AN_IN16: R300.1
AN_IN17: R301.1
AN_IN18: R302.1
AN_IN19: R303.1
AN_IN20: R304.1
AN_IN21: R305.1
AN_IN22: R306.1
AN_IN23: R307.1
AN_OUT0: C340.1, R308.2, R350.2, R360.1
AN_OUT1: C341.1, R309.2, R351.2, R361.1
AN_OUT2: C342.1, R310.2, R352.2, R362.1
AN_OUT3: C343.1, R311.2, R353.2, R363.1
AN_OUT4: C344.1, R312.2, R354.2, R364.1
AN_OUT5: C345.1, R313.2, R355.2, R365.1
AN_OUT6: C346.1, R314.2, R356.2, R366.1
AN_OUT7: C347.1, R315.2, R357.2, R367.1
AN_OUT8: C330.2, R316.2, R370.2, R380.1
AN_OUT9: C331.1, R317.2, R371.2, R381.1
AN_OUT10: C332.1, R318.2, R372.2, R382.1
AN_OUT11: C333.1, R319.2, R373.2, R383.1
AN_OUT12: C334.1, R320.2, R374.2, R384.1
AN_OUT13: C335.1, R321.2, R375.2, R385.1
AN_OUT14: C336.1, R322.2, R376.2, R386.1
AN_OUT15: C337.1, R323.2, R377.2, R387.1
GND: C330.1, C331.2, C332.2, C333.2, C334.2, C335.2, C336.2, C337.2, C340.2, C341.2, C342.2, C343.2, C344.2, C345.2, C346.2, C347.2, C1413.2, R340.2, R341.2, R342.2, R343.2, R344.2, R345.2, R346.2, R347.2, R360.2, R361.2, R362.2, R363.2, R364.2, R365.2, R366.2, R367.2, R380.2, R381.2, R382.2, R383.2, R384.2, R385.2, R386.2, R387.2, R1429.2
IN1: R300.2, R330.2, R340.1
IN2: R301.2, R331.2, R341.1
IN3: R302.2, R332.2, R342.1
IN4: R303.2, R333.2, R343.1
IN5: R304.2, R334.2, R344.1
IN6: R305.2, R335.2, R345.1
IN7: R306.2, R336.2, R346.1
IN8: R307.2, R337.2, R347.1
VCC: D826.1 (A)
VPUP: C1413.1, D826.2 (K), R330.1, R331.1, R332.1, R333.1, R334.1, R335.1, R336.1, R337.1, R350.1, R351.1, R352.1, R353.1, R354.1, R355.1, R356.1, R357.1, R370.1, R371.1, R372.1, R373.1, R374.1, R375.1, R376.1, R377.1, R1429.1

Notes on the sheet:
NOTE: IF INPUT EXCEEDING +5.0 PAIR PULLDOWN WITH 4.7V ZENER
