jharvey/StingrayIII/cad/clock2.sch

## KiCad design cad/clock2.sch (2011-09-04)

Schematic: clock2.sch

Parts:
C131, C132, C141, C142: 0.1uF
R152: 10K
U131, U132: MAX7381AXR106
U141: SN74LVC1G126
U142: SN74LVC1G125
U151: SN74LVC1G175
U152: 74LS166
U153: SN74LVC04G204
U154: SN74AHC1G32
