jharvey/StingrayIII/cad/clock.sch

## KiCad design cad/clock.sch (2011-09-04)

Schematic: clock.sch

Parts:
C131, C132, C141, C142, C151, C161, C181: 0.1uF
TP2: CONN_1
U131, U132: MAX7377
U141: SN74LVC1G126-EP
U142: SN74LVC1G125-EP
U151: SN74LVC1G80-EP
U161: TPS3824-33-Q1
U171: SN74LVC1G32-EP
U181: SN74LVC1G04-Q1

Notes on the sheet:
[0 - 1.8 V]
4 MHz
CLOCK MONITOR, AND DIAGNOSTICS
CLOCK GATE LOGIC
