jharvey/StingrayIII/cad/comm.sch

## KiCad design cad/comm.sch (2011-09-04)

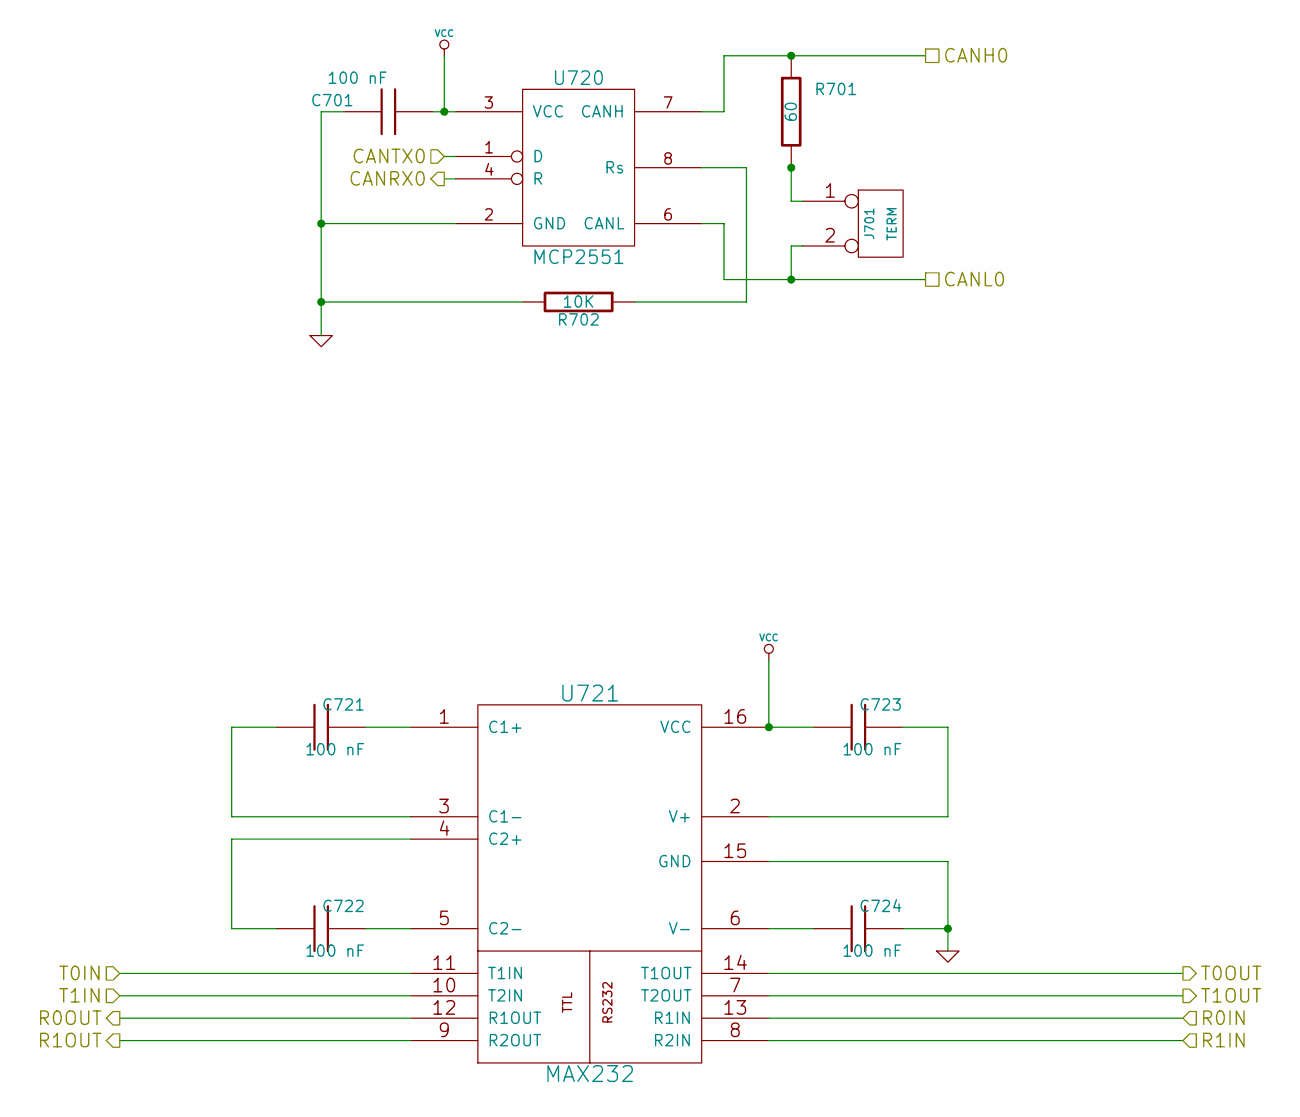
[picture p6: schematic comm.sch]

Parts:
C701, C721, C722, C723, C724: 100 nF
J701: TERM
R701: 60
R702: 10K
U720: MCP2551
U721: MAX232

Connections:
CANH0: R701.1, U720.7 (CANH)
CANL0: J701.2 (PM), U720.6 (CANL)
CANRX0: U720.4 (R)
CANTX0: U720.1 (D)
GND: C701.1, C724.2, R702.2, U720.2 (GND), U721.15 (GND)
unnamed: C721.1, U721.3 (C1-)
unnamed: C721.2, U721.1 (C1+)
unnamed: C722.1, U721.4 (C2+)
unnamed: C722.2, U721.5 (C2-)
unnamed: C723.2, U721.2 (V+)
unnamed: C724.1, U721.6 (V-)
unnamed: J701.1, R701.2
unnamed: R702.1, U720.8 (Rs)
R0IN: U721.13 (R1IN)
R0OUT: U721.12 (R1OUT)
R1IN: U721.8 (R2IN)
R1OUT: U721.9 (R2OUT)
T0IN: U721.11 (T1IN)
T0OUT: U721.14 (T1OUT)
T1IN: U721.10 (T2IN)
T1OUT: U721.7 (T2OUT)
VCC: C701.2, C723.1, U720.3 (VCC), U721.16 (VCC)
