jharvey/StingrayIII/cad/conn.sch

## KiCad design cad/conn.sch (2011-09-04)

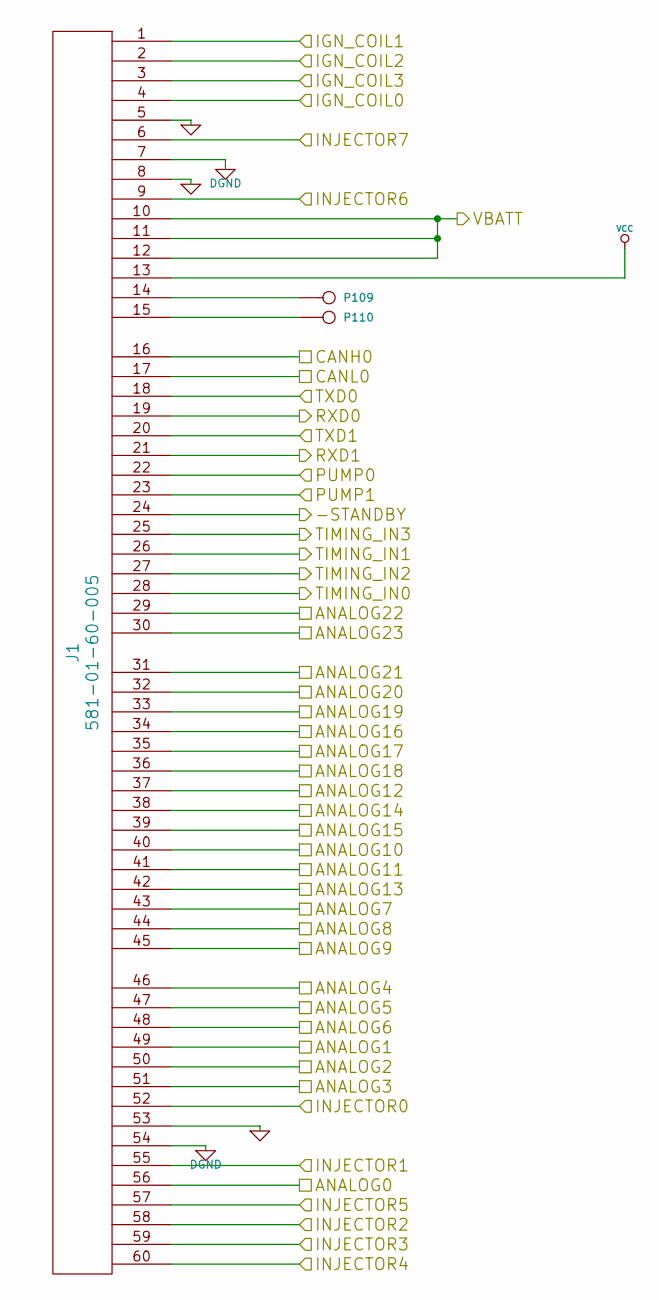
[picture p7: schematic conn.sch]

Parts:
J1: 581-01-60-005
P109, P110: CONN_1

Connections:
-STANDBY: J1.24
ANALOG0: J1.56
ANALOG1: J1.49
ANALOG2: J1.50
ANALOG3: J1.51
ANALOG4: J1.46
ANALOG5: J1.47
ANALOG6: J1.48
ANALOG7: J1.43
ANALOG8: J1.44
ANALOG9: J1.45
ANALOG10: J1.40
ANALOG11: J1.41
ANALOG12: J1.37
ANALOG13: J1.42
ANALOG14: J1.38
ANALOG15: J1.39
ANALOG16: J1.34
ANALOG17: J1.35
ANALOG18: J1.36
ANALOG19: J1.33
ANALOG20: J1.32
ANALOG21: J1.31
ANALOG22: J1.29
ANALOG23: J1.30
CANH0: J1.16
CANL0: J1.17
DGND: J1.7, J1.54
GND: J1.5, J1.8, J1.53
IGN_COIL0: J1.4
IGN_COIL1: J1.1
IGN_COIL2: J1.2
IGN_COIL3: J1.3
INJECTOR0: J1.52
INJECTOR1: J1.55
INJECTOR2: J1.58
INJECTOR3: J1.59
INJECTOR4: J1.60
INJECTOR5: J1.57
INJECTOR6: J1.9
INJECTOR7: J1.6
unnamed: J1.14, P109.1
unnamed: J1.15, P110.1
PUMP0: J1.22
PUMP1: J1.23
RXD0: J1.19
RXD1: J1.21
TIMING_IN0: J1.28
TIMING_IN1: J1.26
TIMING_IN2: J1.27
TIMING_IN3: J1.25
TXD0: J1.18
TXD1: J1.20
VBATT: J1.10, J1.11, J1.12
VCC: J1.13
