jharvey/StingrayIII/cad/dev470.sch

## KiCad design cad/dev470.sch (2011-09-04)

Schematic: dev470.sch

Parts:
C1: 0.01uF
C2, C3, C4, C5, C6, C7, C8, C9, C10, C11, C12, C13, C14, C15, C16, C17, C21, C22, C23, C24, C27: 0.1uF
C18: 0.22uF
C19: 2.2uF
C20, C28, C29, C30: 4.7uF
C25, C26: 18pF
D1: LED
J1: JTAG
J2: AWD
J3: DB9
P1, P2, P3, P4: CONN_36
P5: CAN
P6: CTRM
R1, R2: 10K
R3: 22K
R4: 4.7K
R5: 120
R6: 470
U1: TMS470R1B768
U2: M25P40
U3: MAX3232
U4: TPS79318
U5: SN65HVD232Q
X1: 16MHz

Notes on the sheet:
RTS
CTS
