jharvey/StingrayIII/cad/ign-drivers.sch

## KiCad design cad/ign-drivers.sch (2011-09-04)

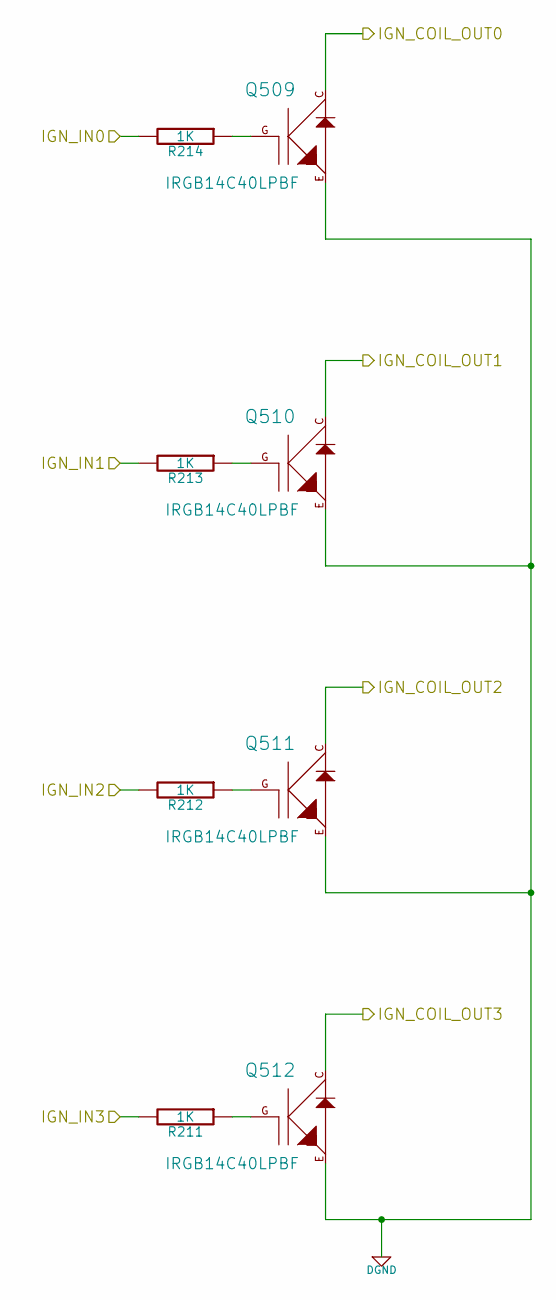
[picture p8: schematic ign-drivers.sch]

Parts:
Q509, Q510, Q511, Q512: IRGB14C40LPBF
R211, R212, R213, R214: 1K; R3_SM0805; tolerance 5%

Connections:
DGND: Q509.E, Q510.E, Q511.E, Q512.E
IGN_COIL_OUT0: Q509.C
IGN_COIL_OUT1: Q510.C
IGN_COIL_OUT2: Q511.C
IGN_COIL_OUT3: Q512.C
IGN_IN0: R214.2
IGN_IN1: R213.2
IGN_IN2: R212.2
IGN_IN3: R211.2
unnamed: Q509.G, R214.1
unnamed: Q510.G, R213.1
unnamed: Q511.G, R212.1
unnamed: Q512.G, R211.1
