jharvey/StingrayIII/cad/input.sch

## KiCad design cad/input.sch (2011-09-04)

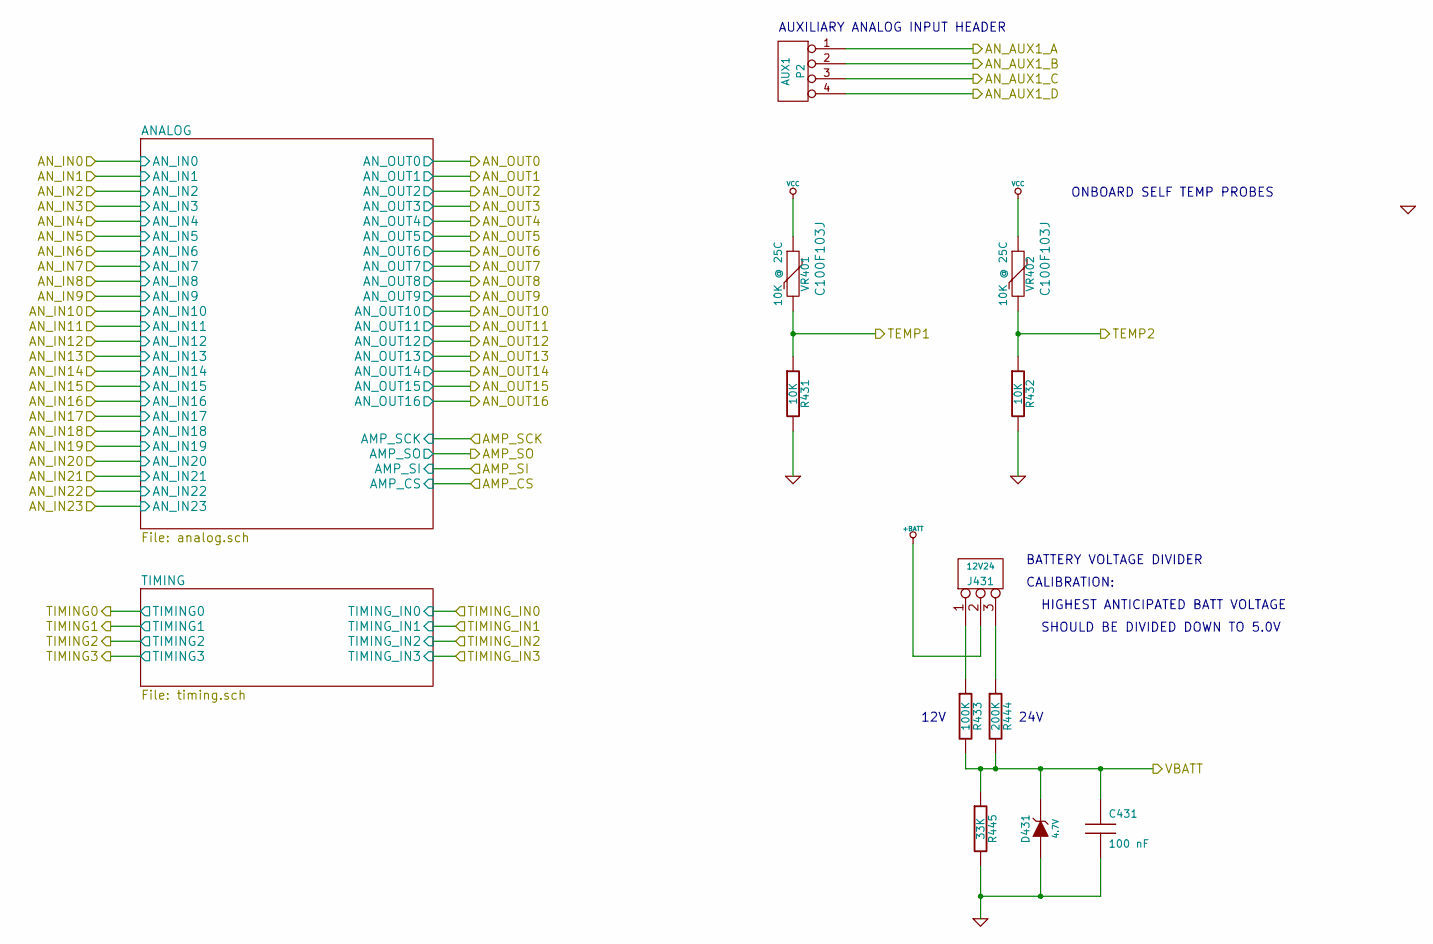
[picture p9: schematic input.sch]

Parts:
C431: 100 nF
D431: 4.7V
J431: 12V24
P2: AUX1
R431, R432: 10K
R433: 100K
R444: 200K
R445: 33K
VR401, VR402: 10K @ 25C

Connections:
+BATT: J431.2 (PM)
AN_AUX1_A: P2.1
AN_AUX1_B: P2.2
AN_AUX1_C: P2.3
AN_AUX1_D: P2.4
GND: C431.2, D431.1 (A), R431.2, R432.2, R445.2
unnamed: J431.1, R433.1
unnamed: J431.3, R444.1
TEMP1: R431.1, VR401.2
TEMP2: R432.1, VR402.2
VBATT: C431.1, D431.2 (K), R433.2, R444.2, R445.1
VCC: VR401.1, VR402.1

Notes on the sheet:
AUXILIARY ANALOG INPUT HEADER
SHOULD BE DIVIDED DOWN TO 5.0V
HIGHEST ANTICIPATED BATT VOLTAGE
CALIBRATION:
BATTERY VOLTAGE DIVIDER
ONBOARD SELF TEMP PROBES
24V
12V
