jharvey/StingrayIII/cad/knock.sch

## KiCad design cad/knock.sch (2011-09-04)

Schematic: knock.sch

Parts:
C852, C854: 100 nF
C853: 4.7uF
C855, C856: C
C1417, C1418: 22pF
R834: 10M
R835, R836, R837, R838: R
U725: TPIC8101
X2: 4MHz
