jharvey/StingrayIII/cad/lm7809.sch

## KiCad design cad/lm7809.sch (2011-09-04)

Schematic: lm7809.sch

Parts:
C1: .1uF
C2: 10 uF
P1, P2: CONN_1
U1: LM7809

Notes on the sheet:
+9V
BATT+
