jharvey/StingrayIII/cad/mcu.sch

## KiCad design cad/mcu.sch (2011-09-04)

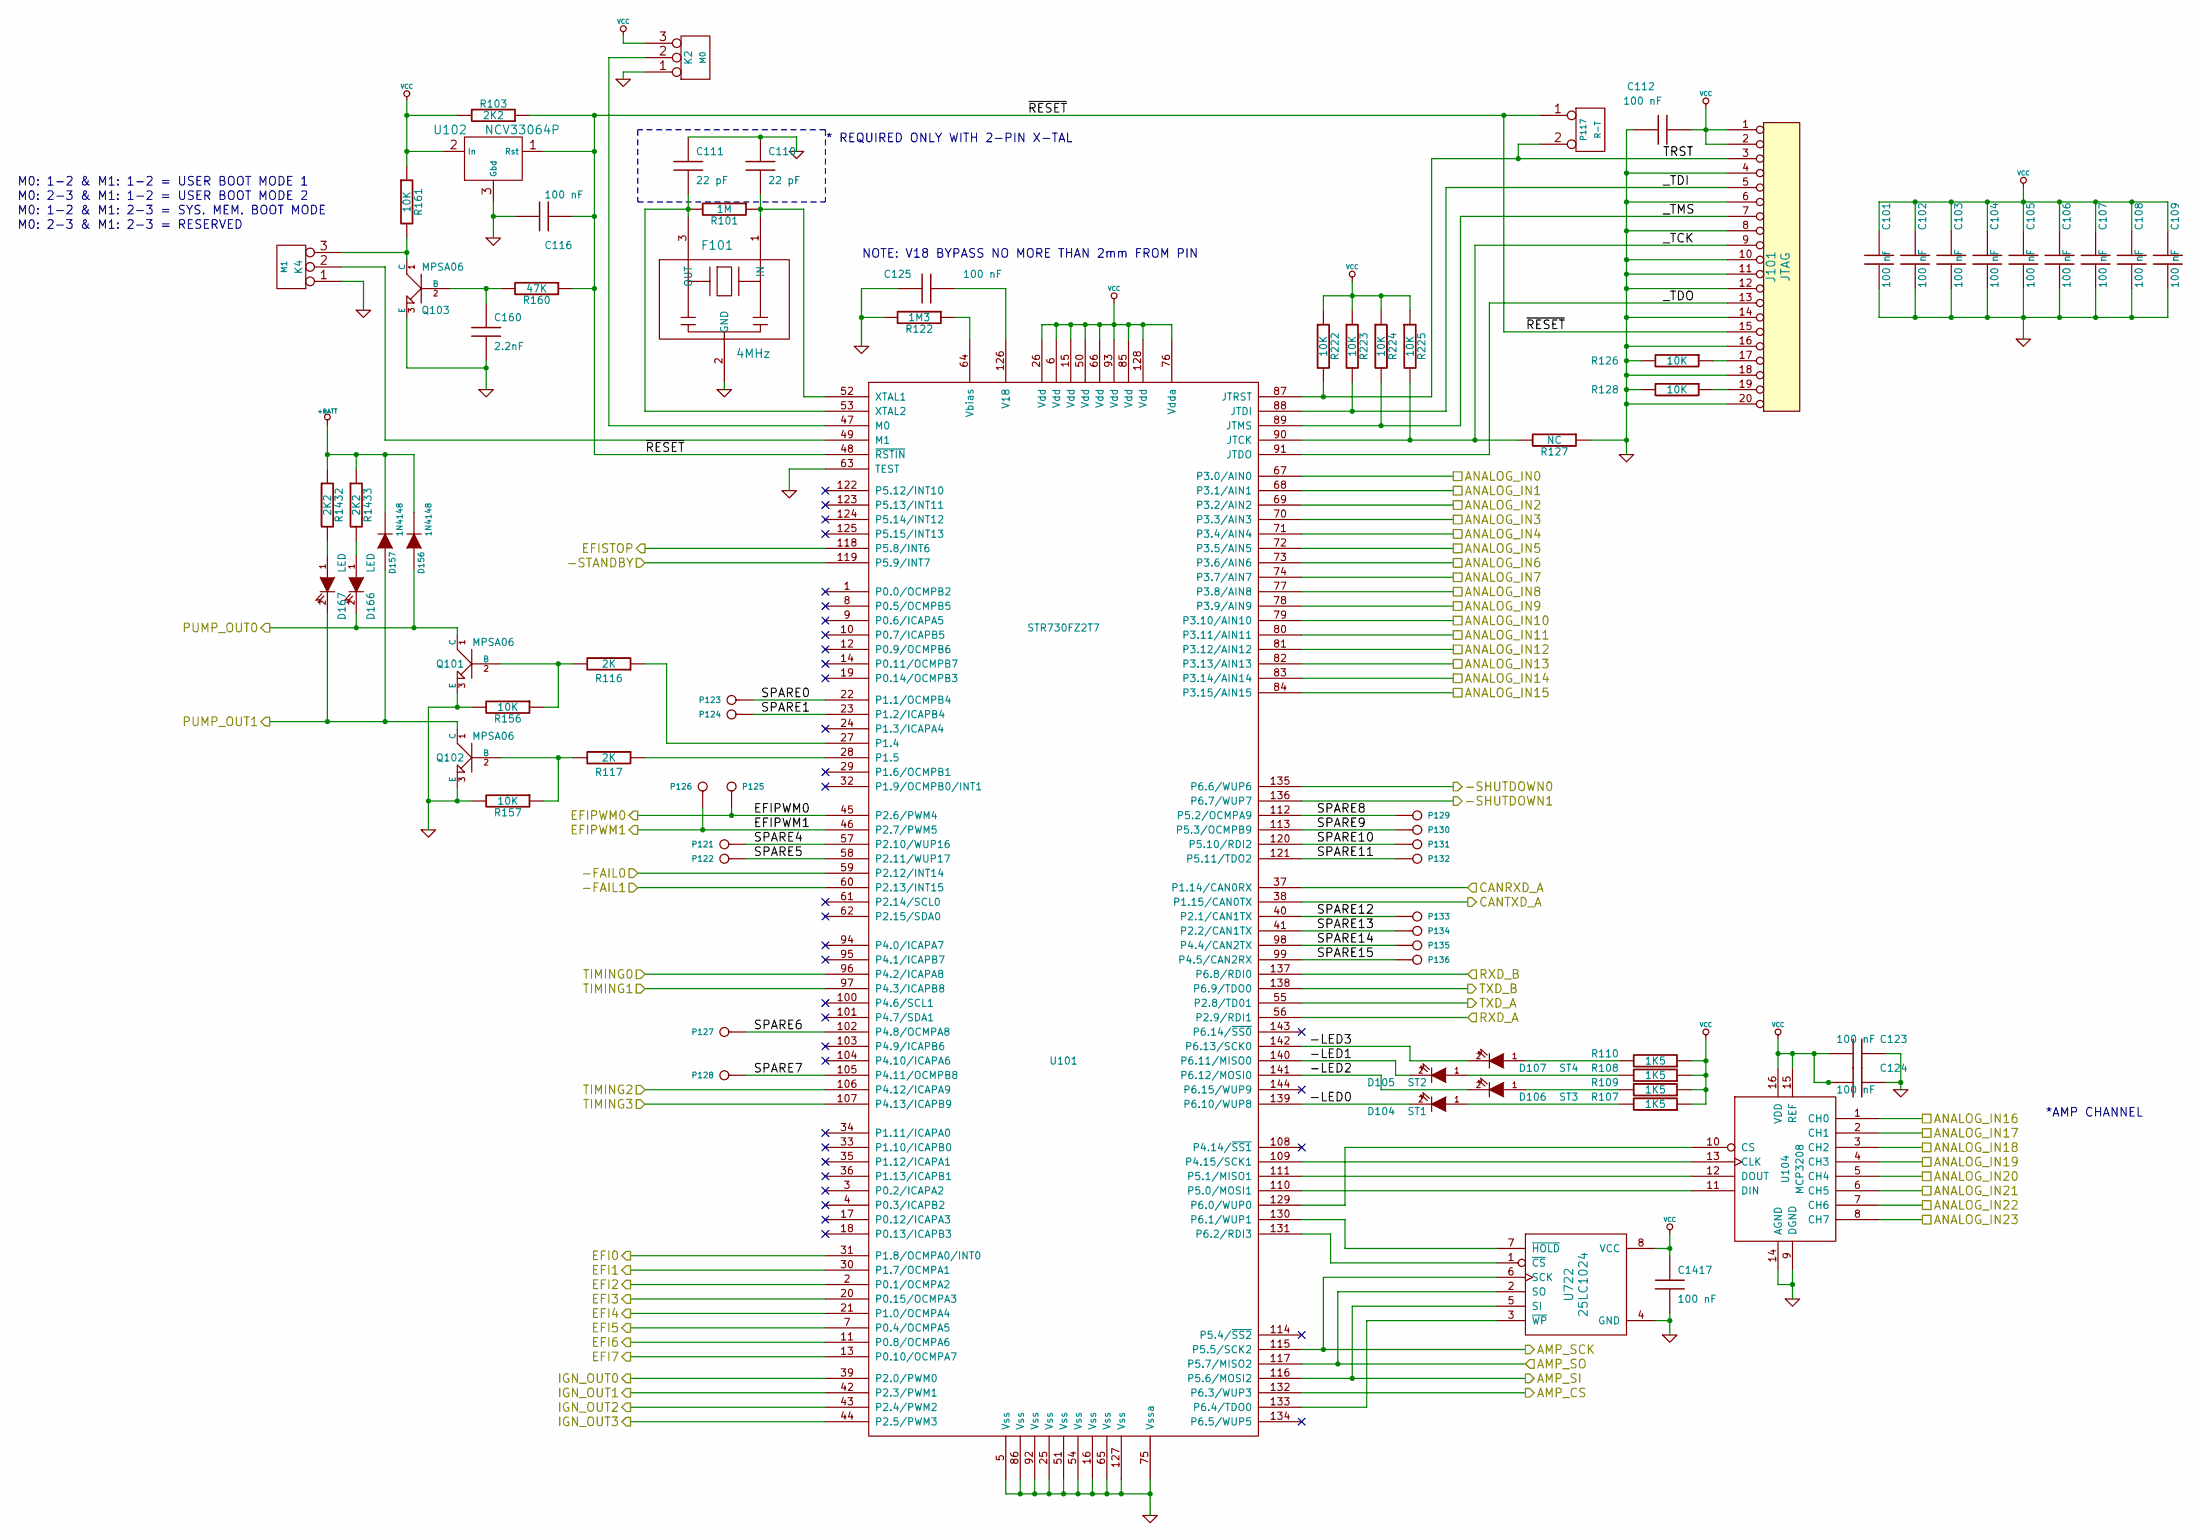
[picture p10: schematic mcu.sch]

Parts:
C101: 100 nf
C102, C103, C104, C105, C106, C107, C108, C109, C112, C116, C123, C124, C125, C1417: 100 nF
C110, C111: 22 pF
C160: 2.2nF
D104: ST1
D105: ST2
D106: ST3
D107: ST4
D156, D157: 1N4148
D166, D167: LED
F101: 4MHz
J101: JTAG
K2: M0
K4: M1
P117: R-T
P121, P122, P123, P124, P125, P126, P127, P128, P129, P130, P131, P132, P133, P134, P135, P136: CONN_1
Q101, Q102, Q103: MPSA06
R101: 1M
R103, R1432, R1433: 2K2
R107, R108, R109, R110: 1K5; R3_SM0805; tolerance 5%
R116, R117: 2K
R122: 1M3
R126, R128, R156, R157, R161, R222, R223, R224, R225: 10K
R127: NC
R160: 47K
U101: STR730FZ2T7
U102: NCV33064P
U104: MCP3208
U722: 25LC1024

Connections:
+BATT: D156.2 (K), D157.2 (K), R1432.1, R1433.1
-FAIL0: U101.59 (P2.12/INT14)
-FAIL1: U101.60 (P2.13/INT15)
-LED0: D104.2 (K), U101.139 (P6.10/WUP8)
-LED1: D105.2 (K), U101.140 (P6.11/MISO0)
-LED2: D106.2 (K), U101.141 (P6.12/MOSI0)
-LED3: D107.2 (K), U101.142 (P6.13/SCK0)
-SHUTDOWN0: U101.135 (P6.6/WUP6)
-SHUTDOWN1: U101.136 (P6.7/WUP7)
-STANDBY: U101.119 (P5.9/INT7)
AMP_CS: U101.132 (P6.3/WUP3)
AMP_SCK: U101.115 (P5.5/SCK2), U722.6 (SCK)
AMP_SI: U101.116 (P5.6/MOSI2), U722.5 (SI)
AMP_SO: U101.117 (P5.7/MISO2), U722.2 (SO)
ANALOG_IN0: U101.67 (P3.0/AIN0)
ANALOG_IN1: U101.68 (P3.1/AIN1)
ANALOG_IN2: U101.69 (P3.2/AIN2)
ANALOG_IN3: U101.70 (P3.3/AIN3)
ANALOG_IN4: U101.71 (P3.4/AIN4)
ANALOG_IN5: U101.72 (P3.5/AIN5)
ANALOG_IN6: U101.73 (P3.6/AIN6)
ANALOG_IN7: U101.74 (P3.7/AIN7)
ANALOG_IN8: U101.77 (P3.8/AIN8)
ANALOG_IN9: U101.78 (P3.9/AIN9)
ANALOG_IN10: U101.79 (P3.10/AIN10)
ANALOG_IN11: U101.80 (P3.11/AIN11)
ANALOG_IN12: U101.81 (P3.12/AIN12)
ANALOG_IN13: U101.82 (P3.13/AIN13)
ANALOG_IN14: U101.83 (P3.14/AIN14)
ANALOG_IN15: U101.84 (P3.15/AIN15)
ANALOG_IN16: U104.1 (CH0)
ANALOG_IN17: U104.2 (CH1)
ANALOG_IN18: U104.3 (CH2)
ANALOG_IN19: U104.4 (CH3)
ANALOG_IN20: U104.5 (CH4)
ANALOG_IN21: U104.6 (CH5)
ANALOG_IN22: U104.7 (CH6)
ANALOG_IN23: U104.8 (CH7)
CANRXD_A: U101.37 (P1.14/CAN0RX)
CANTXD_A: U101.38 (P1.15/CAN0TX)
EFI0: U101.31 (P1.8/OCMPA0/INT0)
EFI1: U101.30 (P1.7/OCMPA1)
EFI2: U101.2 (P0.1/OCMPA2)
EFI3: U101.20 (P0.15/OCMPA3)
EFI4: U101.21 (P1.0/OCMPA4)
EFI5: U101.7 (P0.4/OCMPA5)
EFI6: U101.11 (P0.8/OCMPA6)
EFI7: U101.13 (P0.10/OCMPA7)
EFIPWM0: P125.1, U101.45 (P2.6/PWM4)
EFIPWM1: P126.1, U101.46 (P2.7/PWM5)
EFISTOP: U101.118 (P5.8/INT6)
GND: C101.2, C102.2, C103.2, C104.2, C105.2, C106.2, C107.2, C108.2, C109.2, C110.1, C111.1, C112.1, C116.2, C123.1, C124.1, C125.2, C160.2, C1417.2, F101.2 (GND), J101.4, J101.6, J101.8, J101.10, J101.11, J101.12, J101.14, J101.16, J101.18, J101.20, K2.1, K4.1, Q101.3 (E), Q102.3 (E), Q103.3 (E), R122.2, R126.2, R127.1, R128.2, R156.2, R157.2, U101.5 (Vss), U101.16 (Vss), U101.25 (Vss), U101.51 (Vss), U101.54 (Vss), U101.63 (TEST), U101.65 (Vss), U101.75 (Vssa), U101.86 (Vss), U101.92 (Vss), U101.127 (Vss), U102.3 (Gbd), U104.9 (DGND), U104.14 (AGND), U722.4 (GND)
IGN_OUT0: U101.39 (P2.0/PWM0)
IGN_OUT1: U101.42 (P2.3/PWM1)
IGN_OUT2: U101.43 (P2.4/PWM2)
IGN_OUT3: U101.44 (P2.5/PWM3)
unnamed: C110.2, F101.1 (IN), R101.1, U101.52 (XTAL1)
unnamed: C111.2, F101.3 (OUT), R101.2, U101.53 (XTAL2)
unnamed: C125.1, U101.126 (V18)
unnamed: C160.1, Q103.2 (B), R160.2
unnamed: D104.1 (A), R107.2
unnamed: D105.1 (A), R108.2
unnamed: D106.1 (A), R109.2
unnamed: D107.1 (A), R110.2
unnamed: D166.1 (A), R1433.2
unnamed: D167.1 (A), R1432.2
unnamed: J101.17, R126.1
unnamed: J101.19, R128.1
unnamed: K2.2 (PM), U101.47 (M0)
unnamed: K4.2 (PM), U101.49 (M1)
unnamed: K4.3, Q103.1 (C), R161.2
unnamed: Q101.2 (B), R116.2, R156.1
unnamed: Q102.2 (B), R117.2, R157.1
unnamed: R116.1, U101.27 (P1.4)
unnamed: R117.1, U101.28 (P1.5)
unnamed: R122.1, U101.64 (Vbias)
unnamed: U101.109 (P4.15/SCK1), U104.13 (CLK)
unnamed: U101.110 (P5.0/MOSI1), U104.11 (DIN)
unnamed: U101.111 (P5.1/MISO1), U104.12 (DOUT)
unnamed: U101.129 (P6.0/WUP0), U104.10 (CS)
unnamed: U101.130 (P6.1/WUP1), U722.7 (~HOLD)
unnamed: U101.131 (P6.2/RDI3), U722.1 (~CS)
unnamed: U101.133 (P6.4/TDO0), U722.3 (~WP)
PUMP_OUT0: D156.1 (A), D166.2 (K), Q101.1 (C)
PUMP_OUT1: D157.1 (A), D167.2 (K), Q102.1 (C)
RXD_A: U101.56 (P2.9/RDI1)
RXD_B: U101.137 (P6.8/RDI0)
SPARE0: P123.1, U101.22 (P1.1/OCMPB4)
SPARE1: P124.1, U101.23 (P1.2/ICAPB4)
SPARE4: P121.1, U101.57 (P2.10/WUP16)
SPARE5: P122.1, U101.58 (P2.11/WUP17)
SPARE6: P127.1, U101.102 (P4.8/OCMPA8)
SPARE7: P128.1, U101.105 (P4.11/OCMPB8)
SPARE8: P129.1, U101.112 (P5.2/OCMPA9)
SPARE9: P130.1, U101.113 (P5.3/OCMPB9)
SPARE10: P131.1, U101.120 (P5.10/RDI2)
SPARE11: P132.1, U101.121 (P5.11/TDO2)
SPARE12: P133.1, U101.40 (P2.1/CAN1TX)
SPARE13: P134.1, U101.41 (P2.2/CAN1TX)
SPARE14: P135.1, U101.98 (P4.4/CAN2TX)
SPARE15: P136.1, U101.99 (P4.5/CAN2RX)
TIMING0: U101.96 (P4.2/ICAPA8)
TIMING1: U101.97 (P4.3/ICAPB8)
TIMING2: U101.106 (P4.12/ICAPA9)
TIMING3: U101.107 (P4.13/ICAPB9)
TRST: J101.3, P117.2 (PM), R222.2, U101.87 (JTRST)
TXD_A: U101.55 (P2.8/TD01)
TXD_B: U101.138 (P6.9/TDO0)
VCC: C101.1, C102.1, C103.1, C104.1, C105.1, C106.1, C107.1, C108.1, C109.1, C112.2, C123.2, C124.2, C1417.1, J101.1, J101.2, K2.3, R103.2, R107.1, R108.1, R109.1, R110.1, R161.1, R222.1, R223.1, R224.1, R225.1, U101.6 (Vdd), U101.15 (Vdd), U101.26 (Vdd), U101.50 (Vdd), U101.66 (Vdd), U101.76 (Vdda), U101.85 (Vdd), U101.93 (Vdd), U101.128 (Vdd), U102.2 (In), U104.15 (REF), U104.16 (VDD), U722.8 (VCC)
_TCK: J101.9, R127.2, R225.2, U101.90 (JTCK)
_TDI: J101.5, R223.2, U101.88 (JTDI)
_TDO: J101.13, U101.91 (JTDO)
_TMS: J101.7, R224.2, U101.89 (JTMS)
~RESET: C116.1, J101.15, P117.1, R103.1, R160.1, U101.48 (~RSTIN), U102.1 (Rst)

Notes on the sheet:
*AMP CHANNEL
* REQUIRED ONLY WITH 2-PIN X-TAL
M0: 2-3 & M1: 2-3 = RESERVED
M0: 1-2 & M1: 2-3 = SYS. MEM. BOOT MODE
M0: 2-3 & M1: 1-2 = USER BOOT MODE 2
M0: 1-2 & M1: 1-2 = USER BOOT MODE 1
NOTE: V18 BYPASS NO MORE THAN 2mm FROM PIN
