jharvey/StingrayIII/cad/pwr.sch

## KiCad design cad/pwr.sch (2011-09-04)

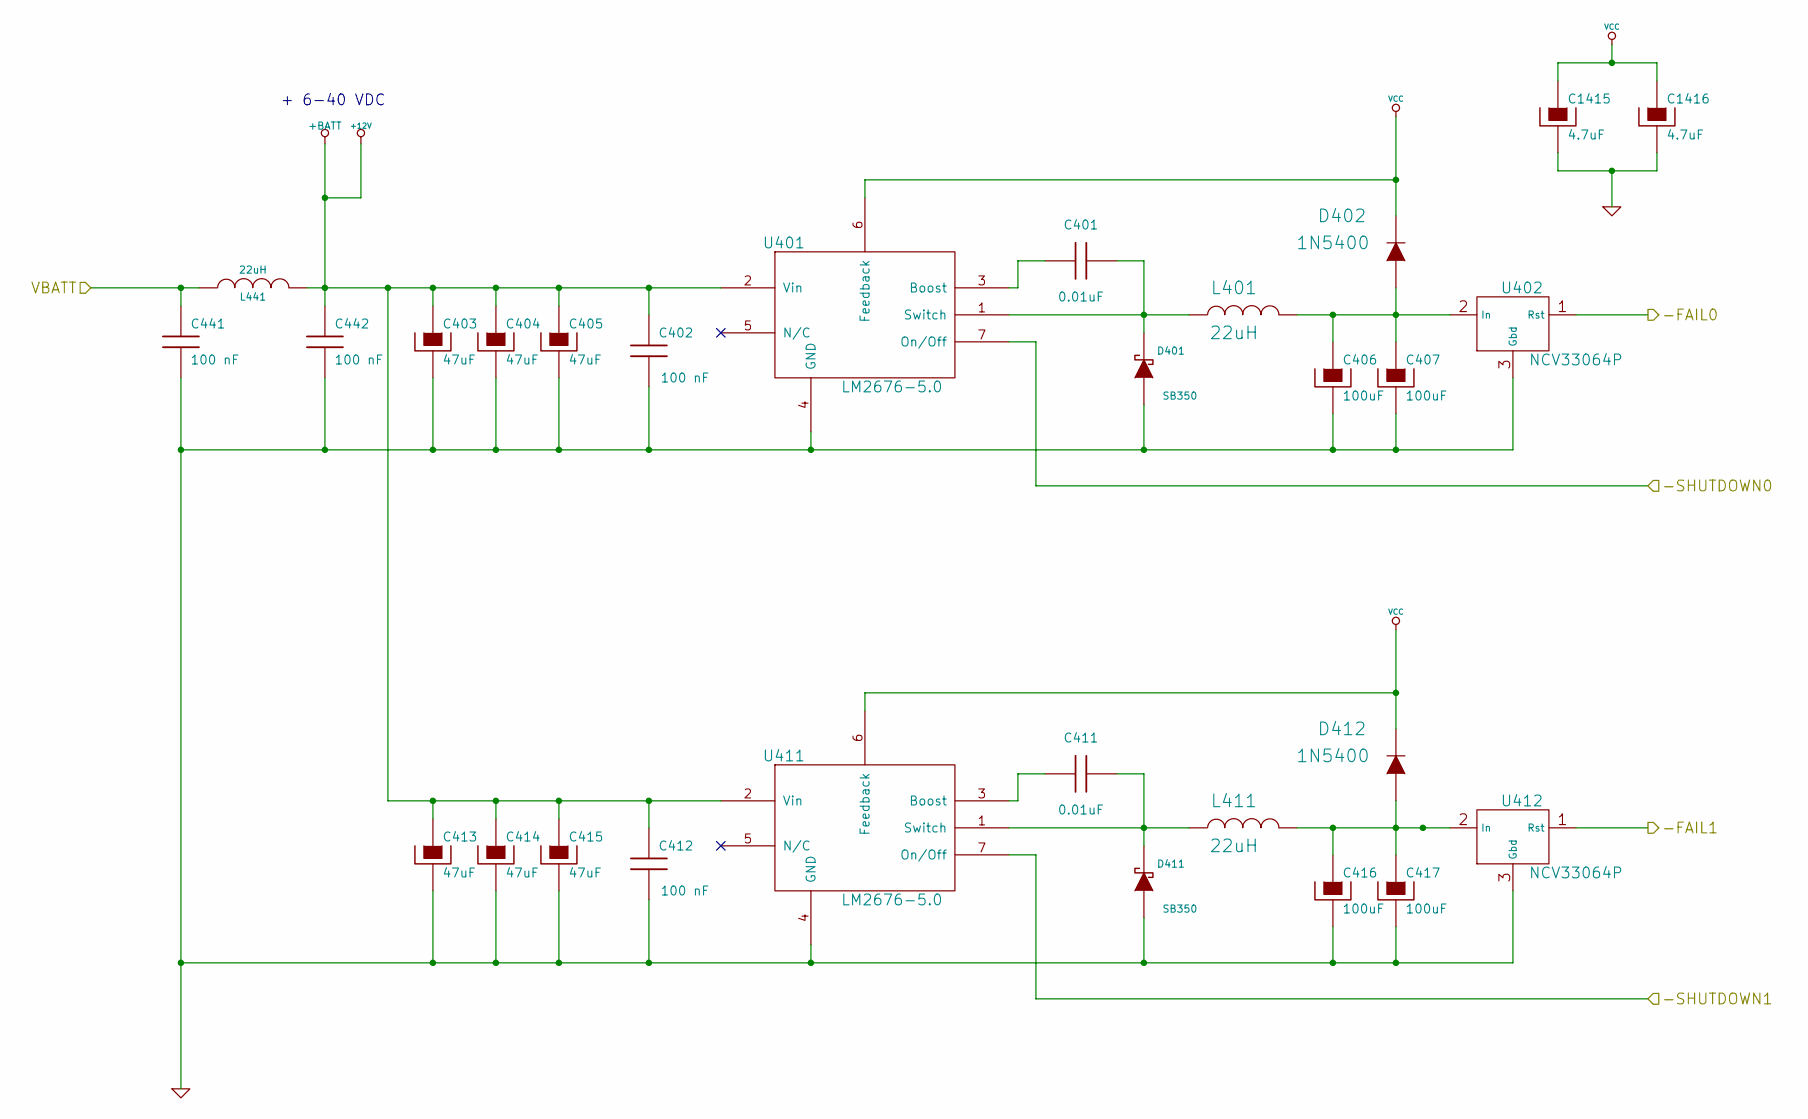
[picture p11: schematic pwr.sch]

Parts:
C401, C411: 0.01uF
C402, C412, C441, C442: 100 nF
C403, C404, C405, C413, C414, C415: 47uF
C406, C407, C416, C417: 100uF
C1415, C1416: 4.7uF
D401, D411: SB350
D402, D412: 1N5400
L401, L411, L441: 22uH
U401, U411: LM2676-5.0
U402, U412: NCV33064P

Connections:
+12V: C402.1, C403.1, C404.1, C405.1, C412.1, C413.1, C414.1, C415.1, C442.1, L441.2, U401.2 (Vin), U411.2 (Vin)
-FAIL0: U402.1 (Rst)
-FAIL1: U412.1 (Rst)
-SHUTDOWN0: U401.7 (On/Off)
-SHUTDOWN1: U411.7 (On/Off)
GND: C402.2, C403.2, C404.2, C405.2, C406.2, C407.2, C412.2, C413.2, C414.2, C415.2, C416.2, C417.2, C441.2, C442.2, C1415.2, C1416.2, D401.1 (A), D411.1 (A), U401.4 (GND), U402.3 (Gbd), U411.4 (GND), U412.3 (Gbd)
unnamed: C401.1, U401.3 (Boost)
unnamed: C401.2, D401.2 (K), L401.1, U401.1 (Switch)
unnamed: C406.1, C407.1, D402.1 (A), L401.2, U402.2 (In)
unnamed: C411.1, U411.3 (Boost)
unnamed: C411.2, D411.2 (K), L411.1, U411.1 (Switch)
unnamed: C416.1, C417.1, D412.1 (A), L411.2, U412.2 (In)
VBATT: C441.1, L441.1
VCC: C1415.1, C1416.1, D402.2 (K), D412.2 (K), U401.6 (Feedback), U411.6 (Feedback)

Notes on the sheet:
+ 6-40 VDC
