jharvey/StingrayIII/cad/serialflash.sch

## KiCad design cad/serialflash.sch (2011-09-04)

Schematic: serialflash.sch

Parts:
C1201, C1202: 0.1uF
U1201, U1202: M25P40
