jharvey/StingrayIII/cad/timing.sch

## KiCad design cad/timing.sch (2011-09-04)

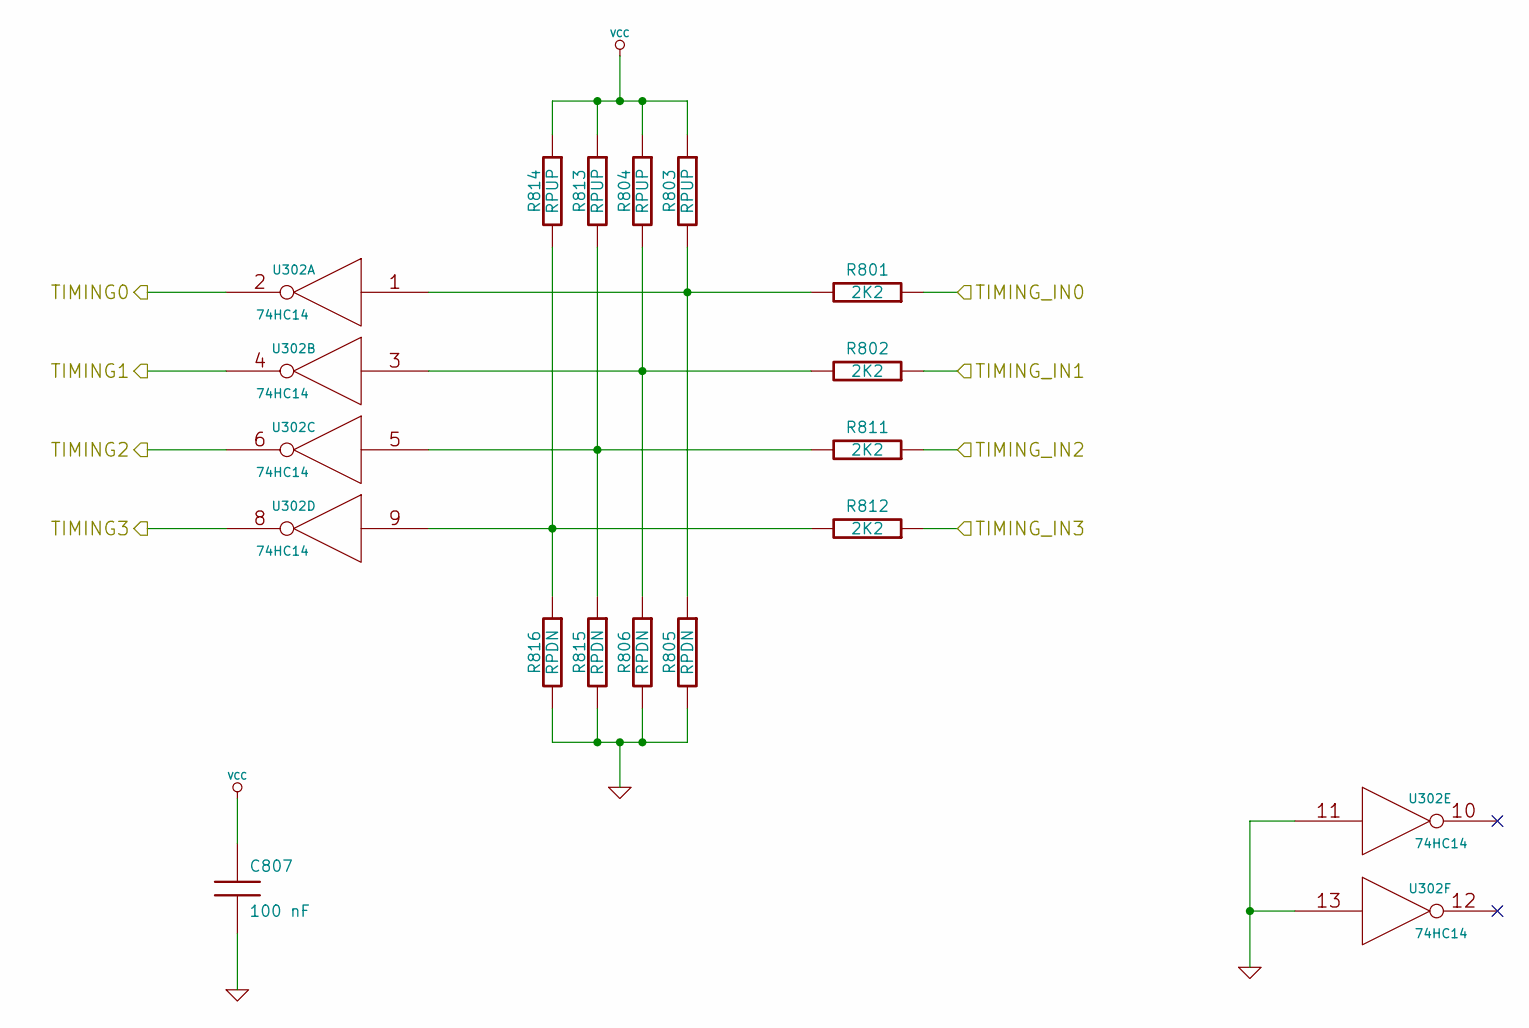
[picture p12: schematic timing.sch]

Parts:
C807: 100 nF
R801, R802, R811, R812: 2K2
R803, R804, R813, R814: RPUP
R805, R806, R815, R816: RPDN
U302: 74HC14

Connections:
GND: C807.2, R805.2, R806.2, R815.2, R816.2, U302.11, U302.13
unnamed: R801.2, R803.2, R805.1, U302.1
unnamed: R802.2, R804.2, R806.1, U302.3
unnamed: R811.2, R813.2, R815.1, U302.5
unnamed: R812.2, R814.2, R816.1, U302.9
TIMING0: U302.2
TIMING1: U302.4
TIMING2: U302.6
TIMING3: U302.8
TIMING_IN0: R801.1
TIMING_IN1: R802.1
TIMING_IN2: R811.1
TIMING_IN3: R812.1
VCC: C807.1, R803.1, R804.1, R813.1, R814.1
