jharvey/StingrayIII/cad/scripts/digi_protect_I3.sch

## KiCad design cad/scripts/digi_protect_I3.sch (2011-09-04)

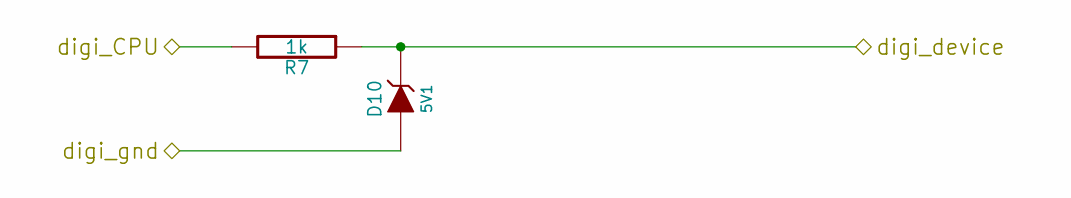
[picture p13: schematic digi_protect_I3.sch]

Parts:
D10: 5V1; SOD-123; voltage 5.1v; mfg# BZT52C5V1-7-F
R7: 1k; SM0805; tolerance 5%; mfg# RMCF0805JT1K00

Connections:
digi_CPU: R7.2
digi_device: D10.2 (K), R7.1
digi_gnd: D10.1 (A)
