jharvey/StingrayIII/(notices)

Notices in the files:
cad/stingray3.sch:
Copyright (C) 2005-2009 by Pike Aerospace Research Corporation
cad/clock3.sch:
Copyright (C) 2006 by Pike Aerospace Research Corporation
cad/efi.sch:
Copyright 2005-2006 by R. Michael Sharkey
cad/knock.sch:
Copyright (C) 2009 by Pike Aerospace Research Corporation
cad/dev470.brd:
Copyright (C) 2006 Pike Aerospace Research Corporation
cad/$savepcb.brd:
Copyright 2006-2008 by Pike Aerospace Research Corporation
(C) 2006-2009 Pike Aerospace Research Corporation
